HorvatMa/RedPitaya_scan/documentation/RedPitaya_dokumentacija.pdf

# Dokumentacija za sistem zajemanja slik z RedPitayo

## Martin Horvat

## 17. september 2025

## 1 FPGA

Program na FPGA je napisan v jeziku Verilog/SystemVerilog z Vivado 2020.2. Sistem je sestavljen iz sledečih blokov za:

- kontrolo parametrov reg ctrl top,
- zajem signala acquire top in integrator top,
- generiranje signala generate top in waveform top in
- prenos zajetega signala v RAM AXI HP top

Celotna blokovna shema je shranjena v datoteki system.pdf.

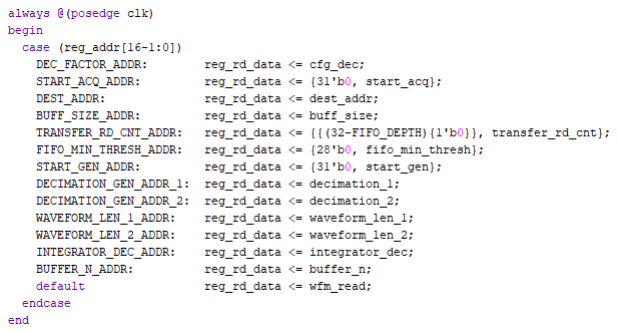
[picture p1: figure]

Slika 1: Koda za branje parametrov

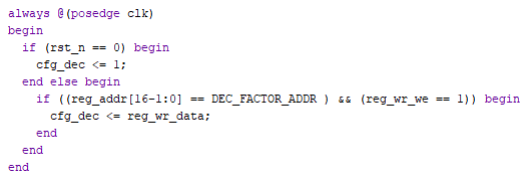
[picture p2: figure]

Slika 2: Koda za zapisovanje parametrov

1

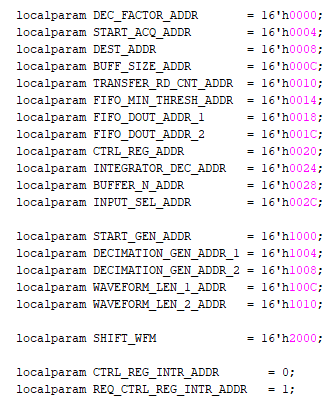
[picture p3: figure]

Slika 3: Definicija lokacij parametrov v delu RAMa

### 1.1 Kontrolni parametri

Blok komunicira s procesnim sistemom preko GP porta AXI protokola, zato ima vhode in izhode kot jih ta zahteva. Komunikacija poteka preko Xilinxovega bloka reg ctrl (Slika 4), kjer lahko nato nastavitve preberemo (Slika 1) oziroma zapišemo (Slika 2). S parametri so definirane lokacije, kjer se v delu RAMa, glede na mapiranje AXI protokola nahajajo spremenljivke (Slika 3). Prebrane vrednosti oziroma registri, ki nosijo vrednost katera se zapiše v RAM, so nato vhodi in izhodi v blok reg ctrl top.

### 1.2 Zajem signala

Signal iz detektorja gre na en ADC vhod, na drugi vhod pa pride signal pozicije hitrega ogledala. Prvi signal gre nato skozi integrator, ki po trapeznem pravilu sešteje prispevke na vhodu v vsakem ciklu ure. Dobljena dva signala skupaj z vrednostjo počasnega signala prideta na vhod bloka acquire top. Ta poskrbi, da se zgodi zapis vrednosti pozicij in integriranega signala na vsakih dec cnt ciklov ure (Slika 5). Hkrati tudi ponastavi integrator.

### 1.3 Generiranje signala

Isti del spomina, ki služi nastavljanju nastavitvenih registrov v bloku ctrl reg, je po nekem mejnem naslovu, definiranem z WFM SHIFT v istem bloku, namenjen vzorcem arbitrarne funkcije, ki jo želimo generirati. In sicer je prvih 16384 vzorcev namenjenih prvi funkciji in preostalih 16384 drugi. Za zapisovanje iz RAMa v pomnilnik na FGPA poskrbi blok waveform top. Vsebuje dva Xilinxova generatorja spomina - vsakega za en izhod (Slika 6). Vrednost, ki jo dobi preko bloka reg Ctrl z informacijo o naslovu, s kjer prihaja vrednost, ki jo prav tako dobi od istega bloka, zapiše na ustrezno pozicijo ustreznega generatorja spomina (Slika 7).

Blok generator top nato poskrbi za branje prave vrednosti iz spomina preko decimacije generatorja,

2

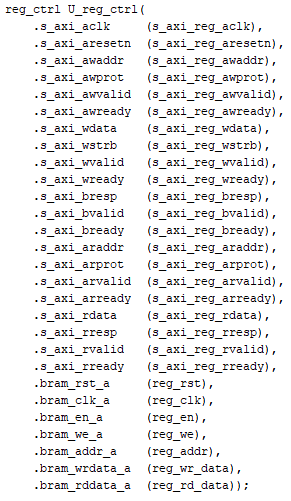
[picture p4: figure]

Slika 4: Xilinxov blok reg ctrl

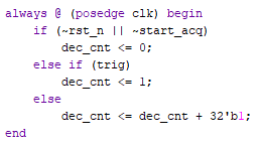
[picture p5: figure]

Slika 5: Koda za proženje zapisa in ponastavitve integratorja

ki jo nato pelje na DAC izhod.

### 1.4 Komunikacija zajetega signala

Najzapletenejši del logike se nahaja v delu, ki skrbi za efektiven prenos zajetega signala iz FIFO v RAM. Za to se namesto GP porta (General Purpose) uporabi port HP (High Performance). Blok

3

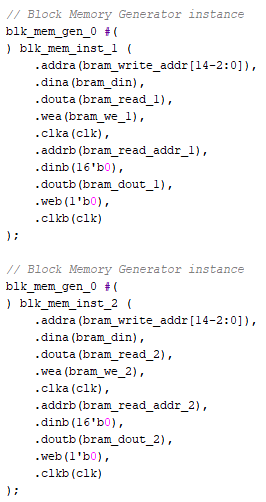
[picture p6: figure]

Slika 6: Dva blokovna spomina za vsakega od izhodov

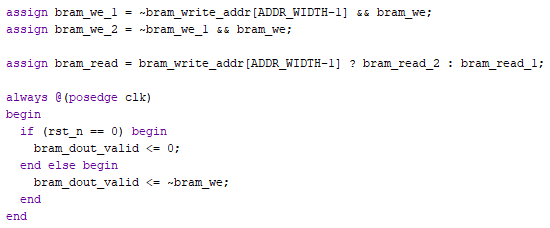
[picture p7: figure]

Slika 7: Izbira pravega spomina za zapis vrednosti

Acquire HP top je sestavljen iz dveh podblokov axi s2mm, ki poskrbi, da logika sledi protokolu AXI in axi control, ki poskrbi za shranjevanje vzorcev v FIFO spomin in iniciacijo prenosa. Ko da blok acquire top signal proženja, se vzorci iz integratorja in dveh pozicijskih signalov (Slika 8) shranijo v FIFO spomin (Slika 9). Ko število shranjenih vzorcev v FIFO spominu preseže mejno vrednost, se inicira prenos v RAM, v kolikor je zastavica request interrupt nastavljena na 1 (Slika 10. Ko je prenos zaključen se postavi zastavica intr na 1, kar sproži interrupt in program na strani OS

4

prebere vzorce iz RAMa. Ko zaključi ponovno postavi zastavico request interrupt na 1 in cikel se ponovi. Skoraj vsa ostala logika poskrbi, da prenos sledi protokolu.

Slika 8: Sestavljanje FIFO zapisa

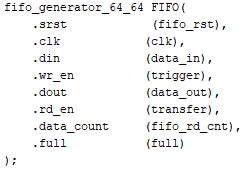
[picture p8: figure]

Slika 9: Zapis v fifo

Slika 10: Zastavice za iniciacio prenosa

5

## 2 DeviceTree

Da lahko na strani OS komuniciramo z napravo, moramo definira, kjeje v RAMu se nahaja. V Vivadu sta v zavihku Address manager definirani poziciji kamor komunicirata GP in HP protokola (Slika 11). V OS dodamo definicijo naprave z devicetree overlayom, ki je prikazan na sliki 12. Relevantni deli so reg, kjer določimo pozicijo v RAM, ki se ujema s tisto nastavljeno v Vivadu in interrupts, kjer je definiran interrupt. To datoteko nato compilamo in apliciramo z ustreznima skriptama compile dt.sh in apply overlay.sh. To doda napravo preko generičnih UIO gonilnikov. Do naprave se lahko tedaj dostopa znotraj C programa.

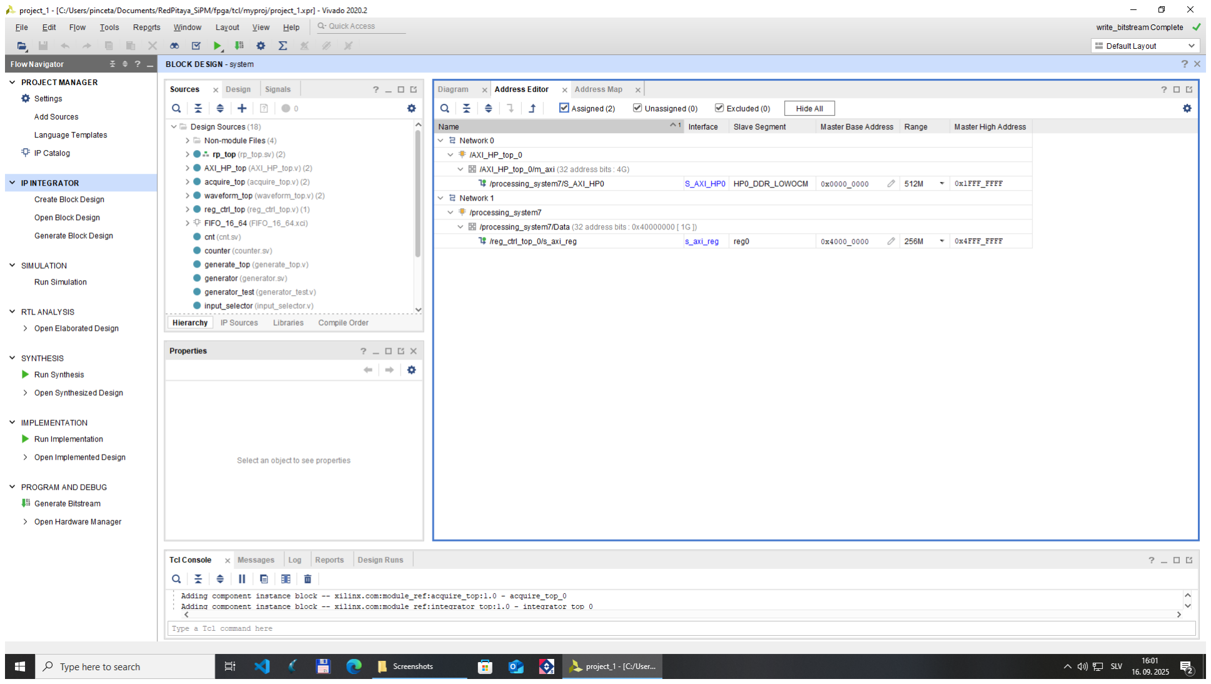
[picture p9: figure]

Slika 11: Definicije pozicij v RAMu, kamor pišeta protokola

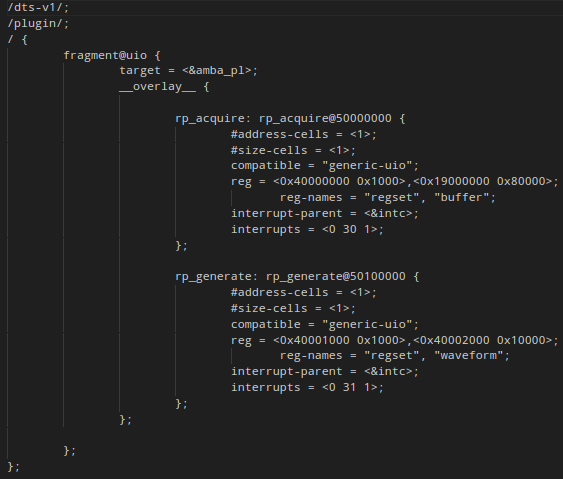
[picture p10: figure]

Slika 12: DeviceTree overlay

6

## 3 C program

### 3.1 Identifikacija UIO naprav

V C kodi lahko najprej poiščemo vse UIO naprave v sistemu in jih shranimo na seznam. Ta seznam lahko nato preiščemo da najdemo pravo naprvao (v našem primeru rp acquire in rp generate). Pomožne funkcije za to so definirane v uio parser.h.

### 3.2 Mapiranje registrov in bufferja

Ko najdemo pravo UIO napravo, lahko pozicije v spominu mapiramo na strukture (Slika 13 in 14). Strukture in funkcije za manipulacijo naprav so definirane v generator.h in oscilloscope.h. Spremenljivke znotraj strukture in njihovi relativni naslovi sovpadajo s tistimi definiranimi na sliki
3. Enako velja za waveform, kjer je spomin razdeljen na dva dela, vsakega za en izhod (Slika 14). Ko torej spremenimo katerokoli od spremenljivk znotraj mapiranih struktur, oz. jo preberemo, bo logika v FPGA poskrbela, da se sprememba zapiše oz. prebere.

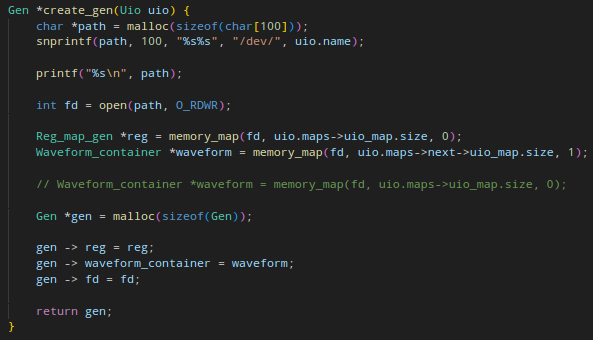
[picture p11: figure]

Slika 13: Funkcija za dodajanje generatorja

### 3.3 Prenos FIFO v RAM

Ko so doseženi pogoji za prenos na FPGA strani, se začne prenos in ko se ta konča, FPGA sproži interrupt. Da ga ujamemo, moramo zanj poslušati (Slika 15). Ko ga program zazna, prenese vse podatke iz deljenega dela RAM na drugo pozicijo in zaprosi za nov interrupt (Slika 16), saj je tedaj del RAMa prost za nove podatke. Cikel se nato ponovi.

### 3.4 TCP komunikacija

Ko program prenese podatke iz deljenega RAM dela, jih takoj zapiše v buffer (Slika 16) in inicira TCP prenos do klienta na osebnem računalniku, kjer se sestavi slika na podlagi zgornje in spodnje meje pozicije in resolucije.

7

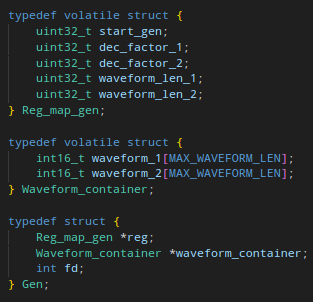
[picture p12: figure]

Slika 14: Definicija struktur za generator

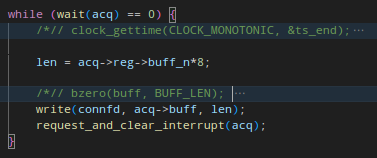
[picture p13: figure]

Slika 15: Poslušanje za interrupt znotraj TCP zanke

Slika 16: Brisanje interrupta in zaprošanje za novega

8
