HorvatMa/RedPitaya_scan/documentation/screenshots/create_acq.png

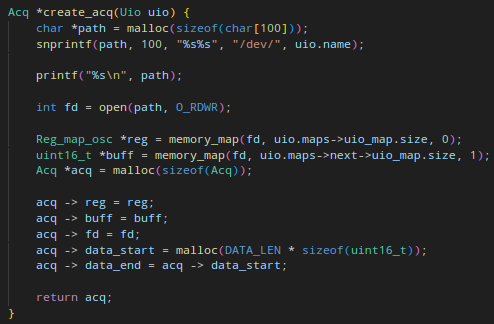
documentation/screenshots/create_acq.png
