HorvatMa/RedPitaya_scan/documentation/screenshots/get_uios.png

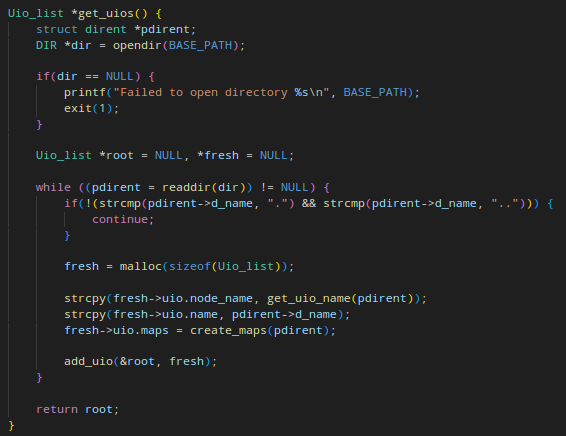
documentation/screenshots/get_uios.png
