HorvatMa/RedPitaya_scan/documentation/screenshots/Screenshot (24).png

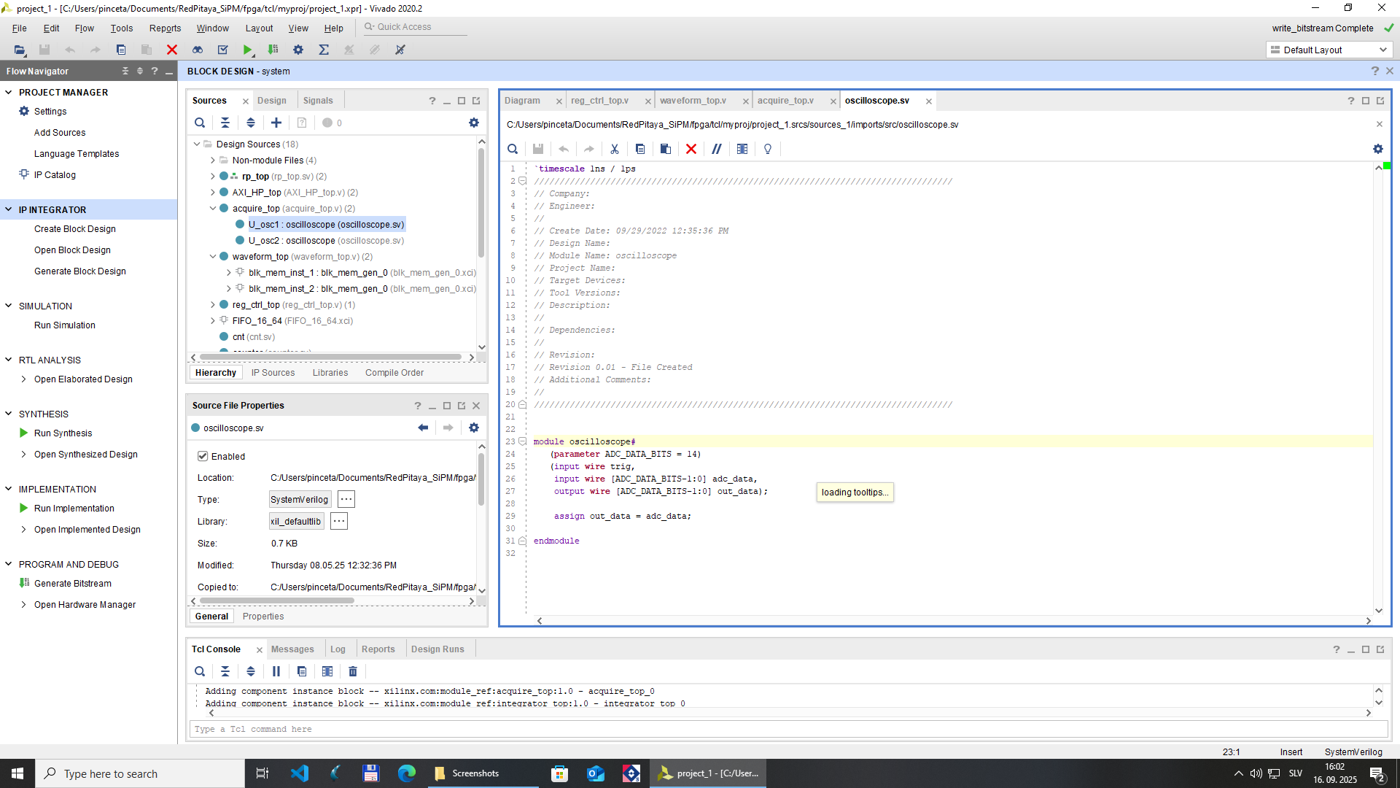
documentation/screenshots/Screenshot (24).png
