HorvatMa/RedPitaya_scan/documentation/screenshots/Screenshot (25).png

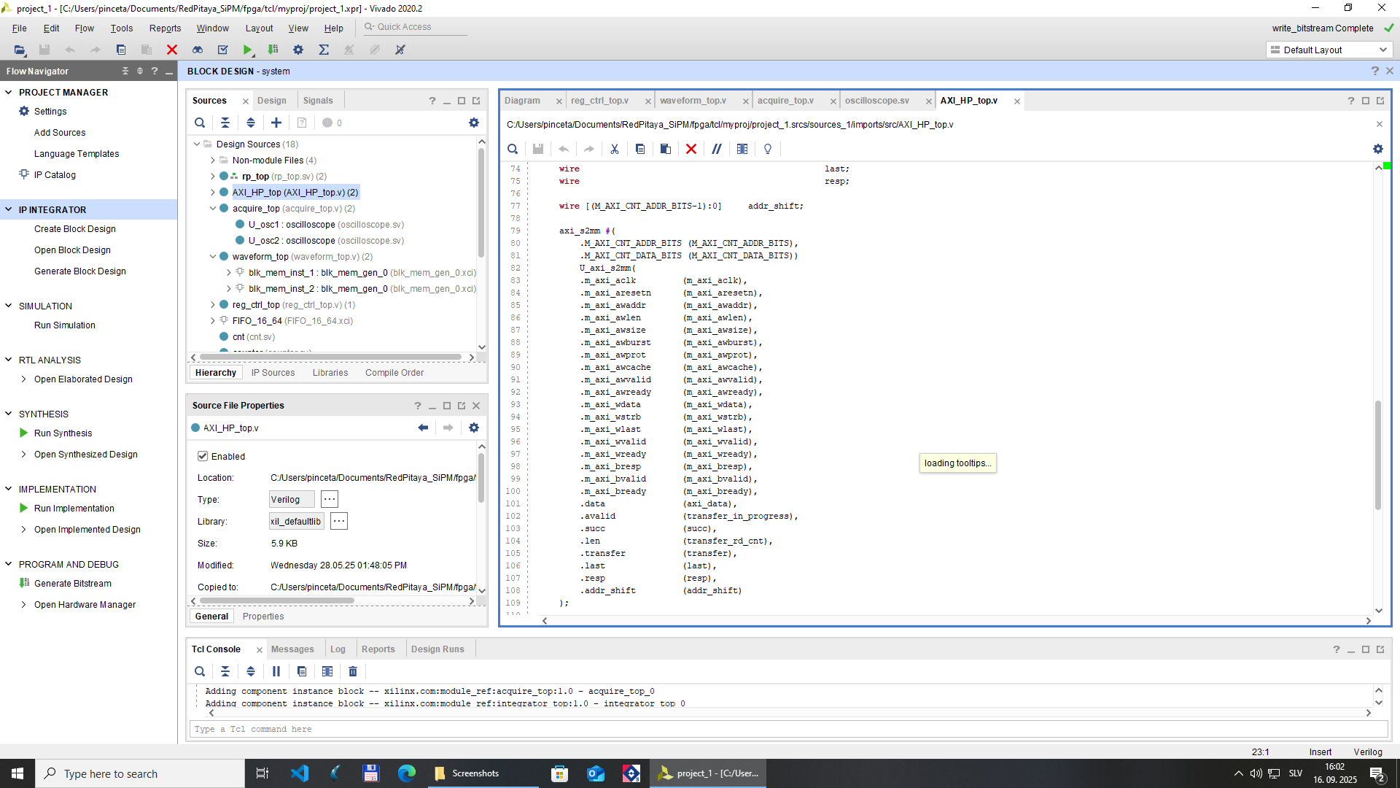
documentation/screenshots/Screenshot (25).png
