HorvatMa/RedPitaya_scan/documentation/screenshots/Screenshot (26).png

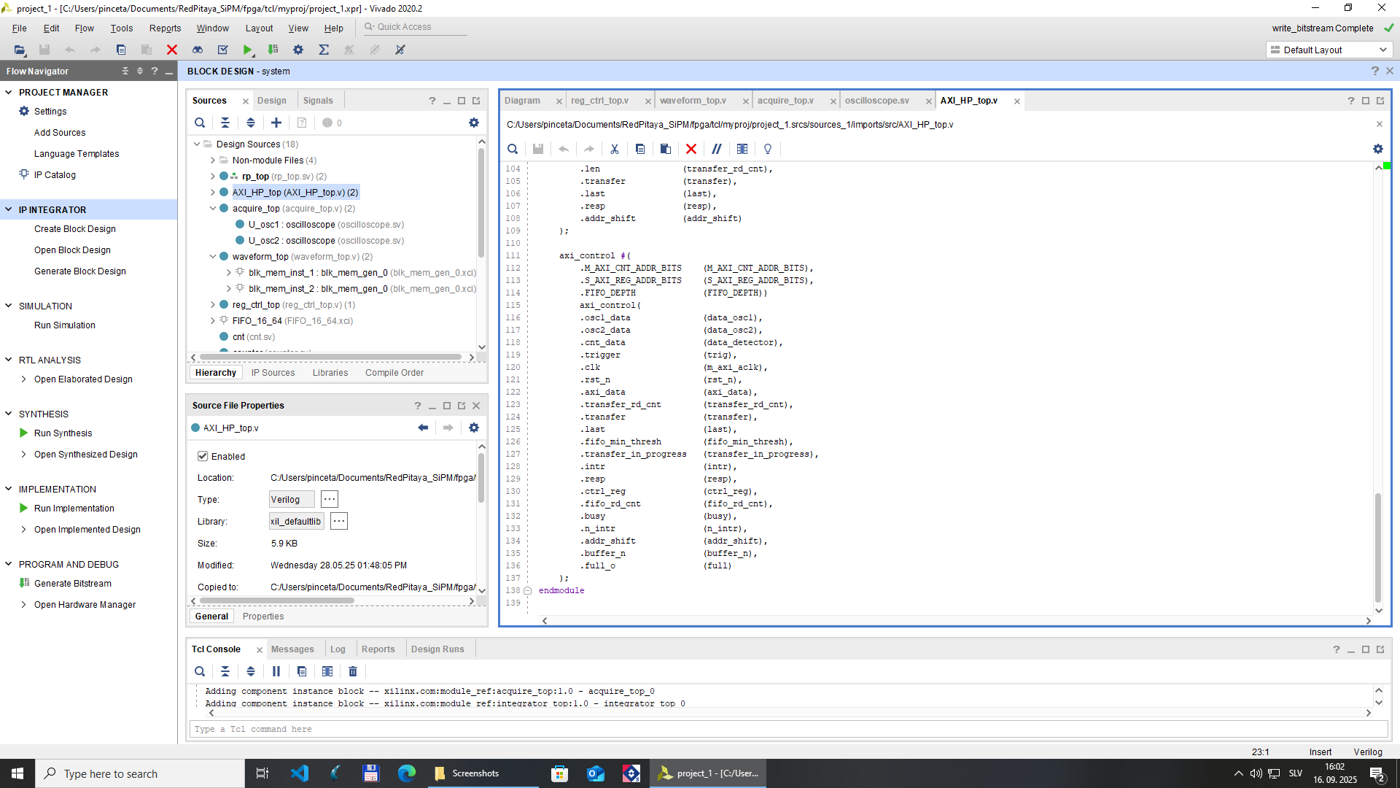
documentation/screenshots/Screenshot (26).png
