HorvatMa/RedPitaya_scan/documentation/screenshots/Screenshot (27).png

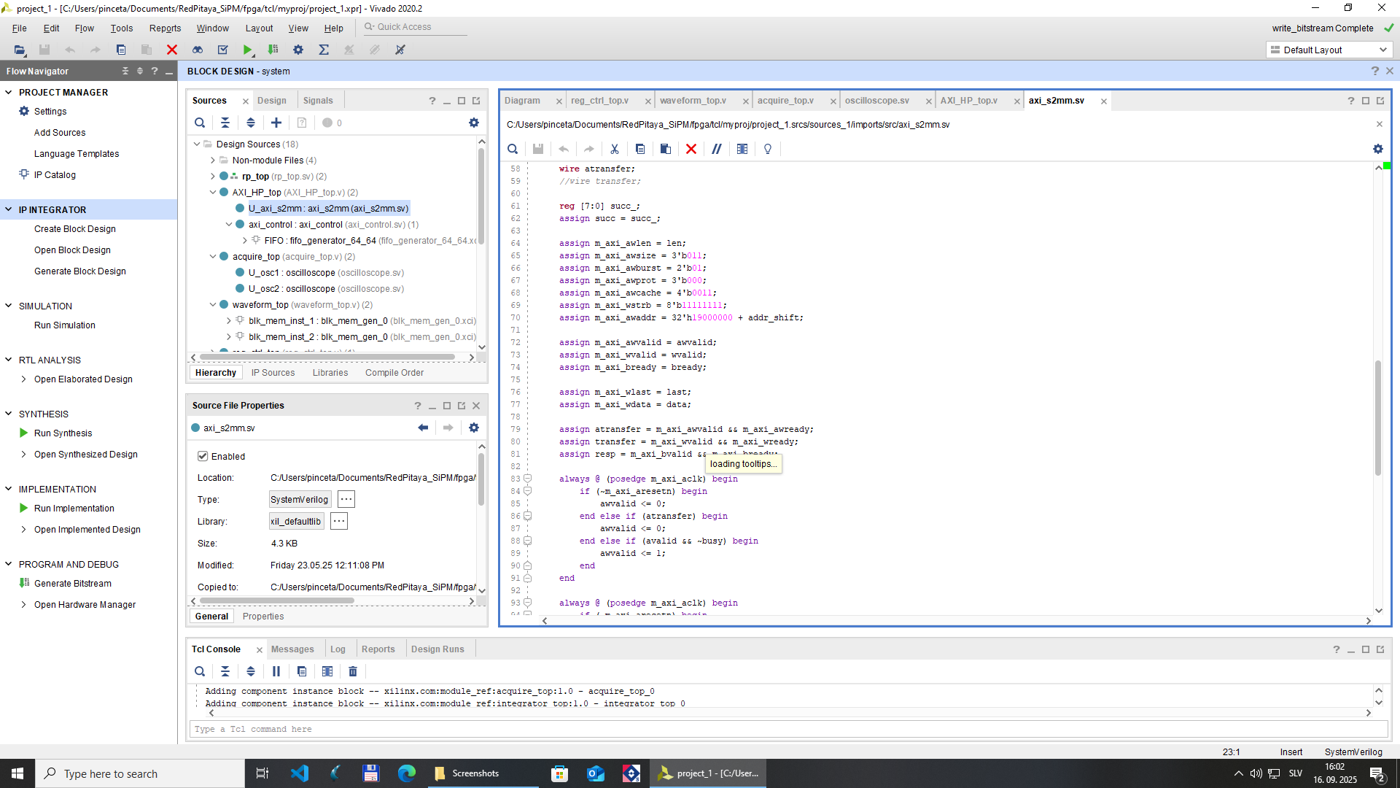
documentation/screenshots/Screenshot (27).png
