HorvatMa/RedPitaya_scan/documentation/screenshots/Screenshot (28).png

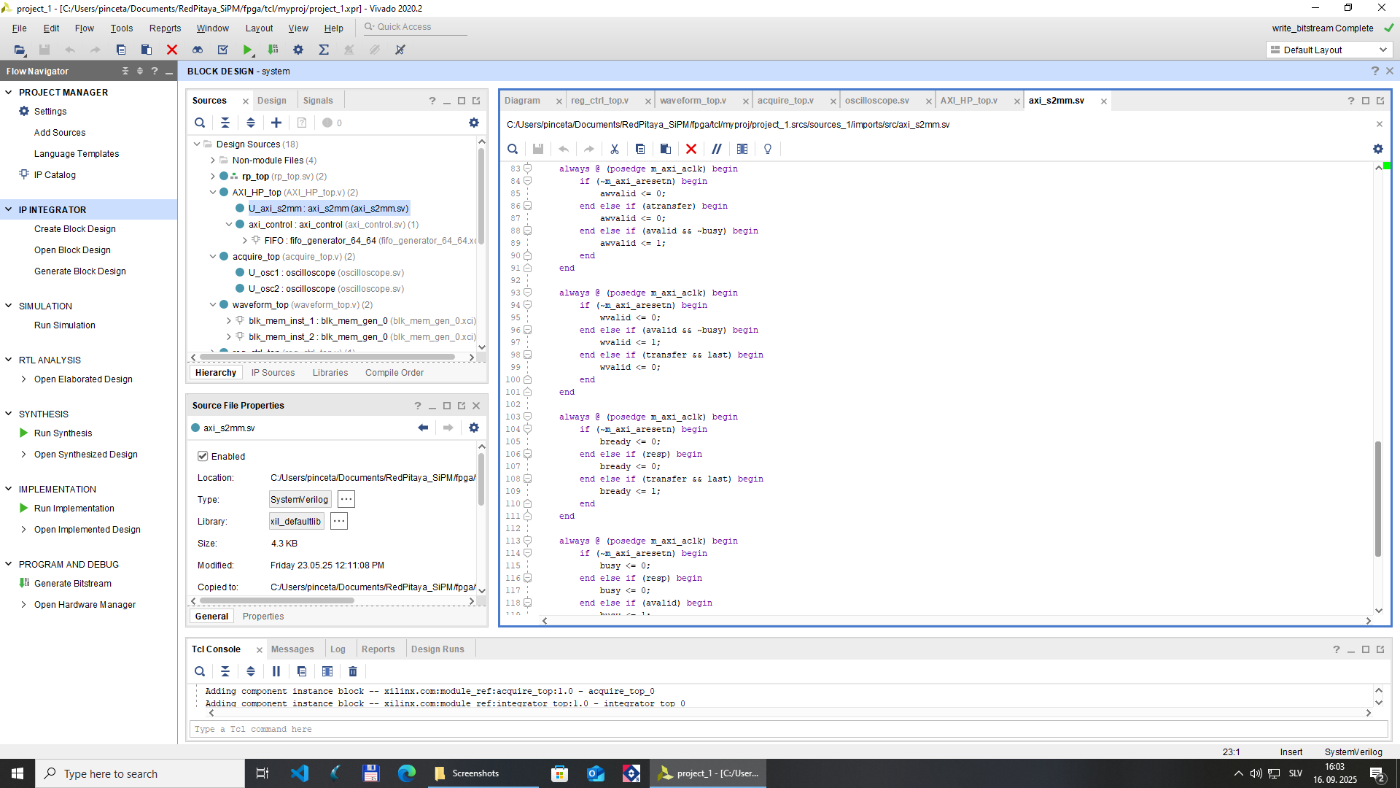
documentation/screenshots/Screenshot (28).png
