HorvatMa/RedPitaya_scan/documentation/screenshots/Screenshot (29).png

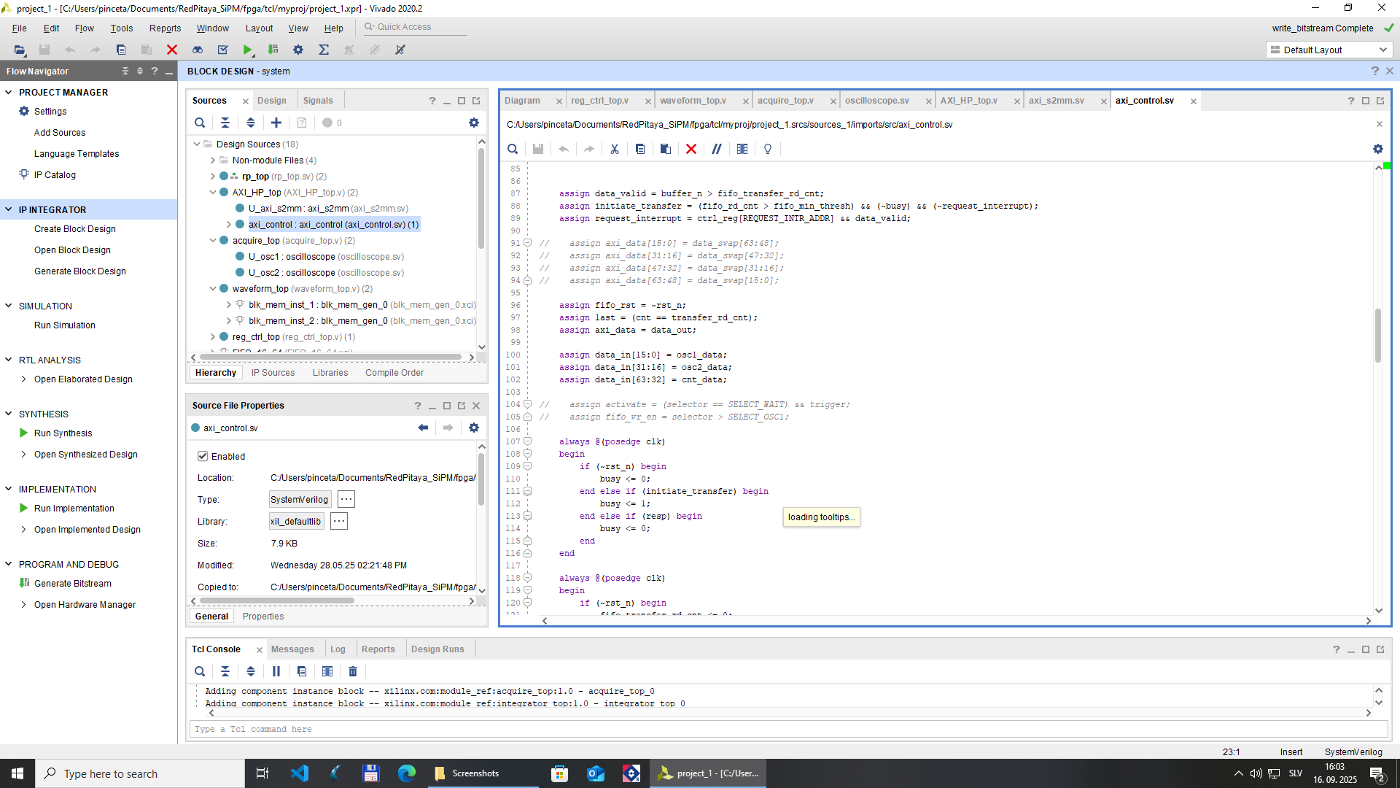
documentation/screenshots/Screenshot (29).png
