HorvatMa/RedPitaya_scan/documentation/screenshots/Screenshot (30).png

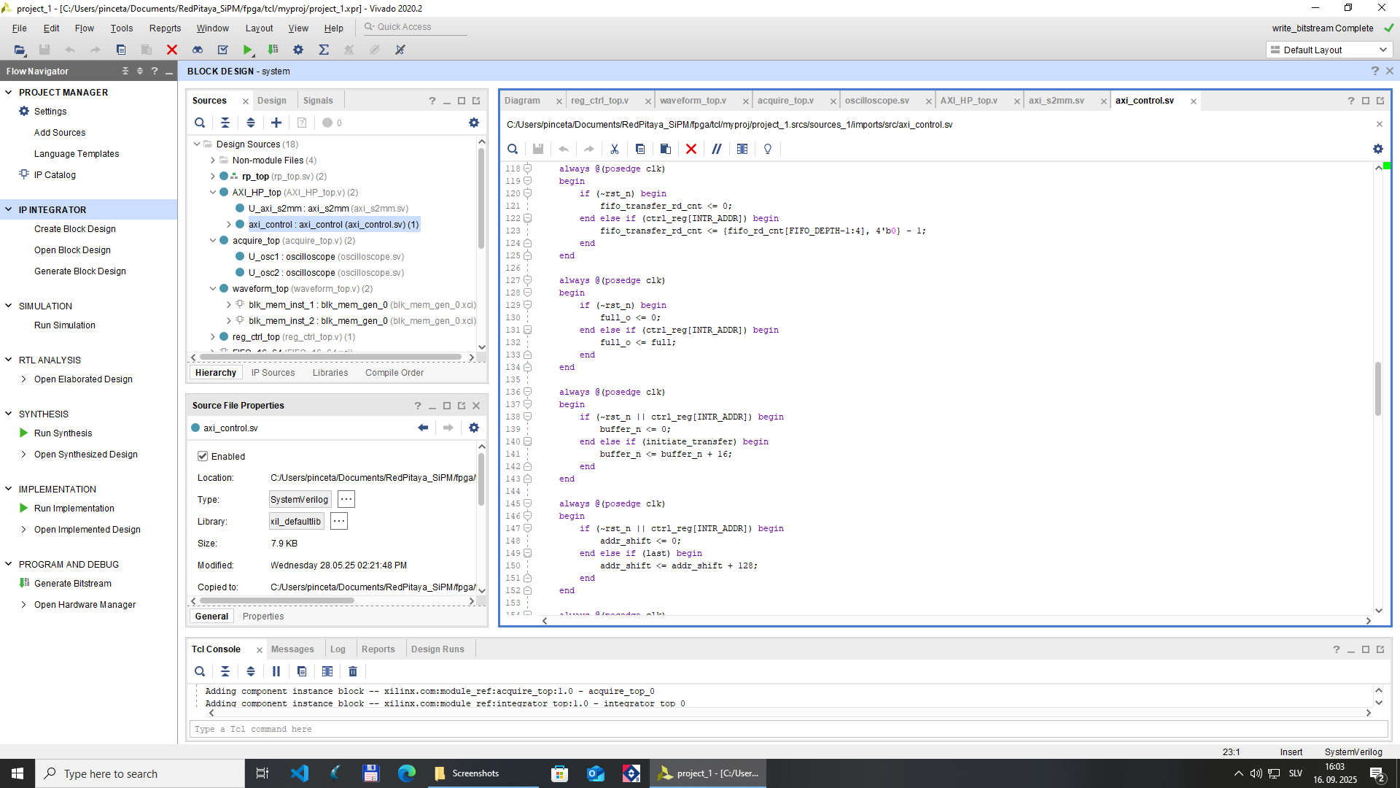
documentation/screenshots/Screenshot (30).png
