HorvatMa/RedPitaya_scan/documentation/screenshots/Screenshot (34).png

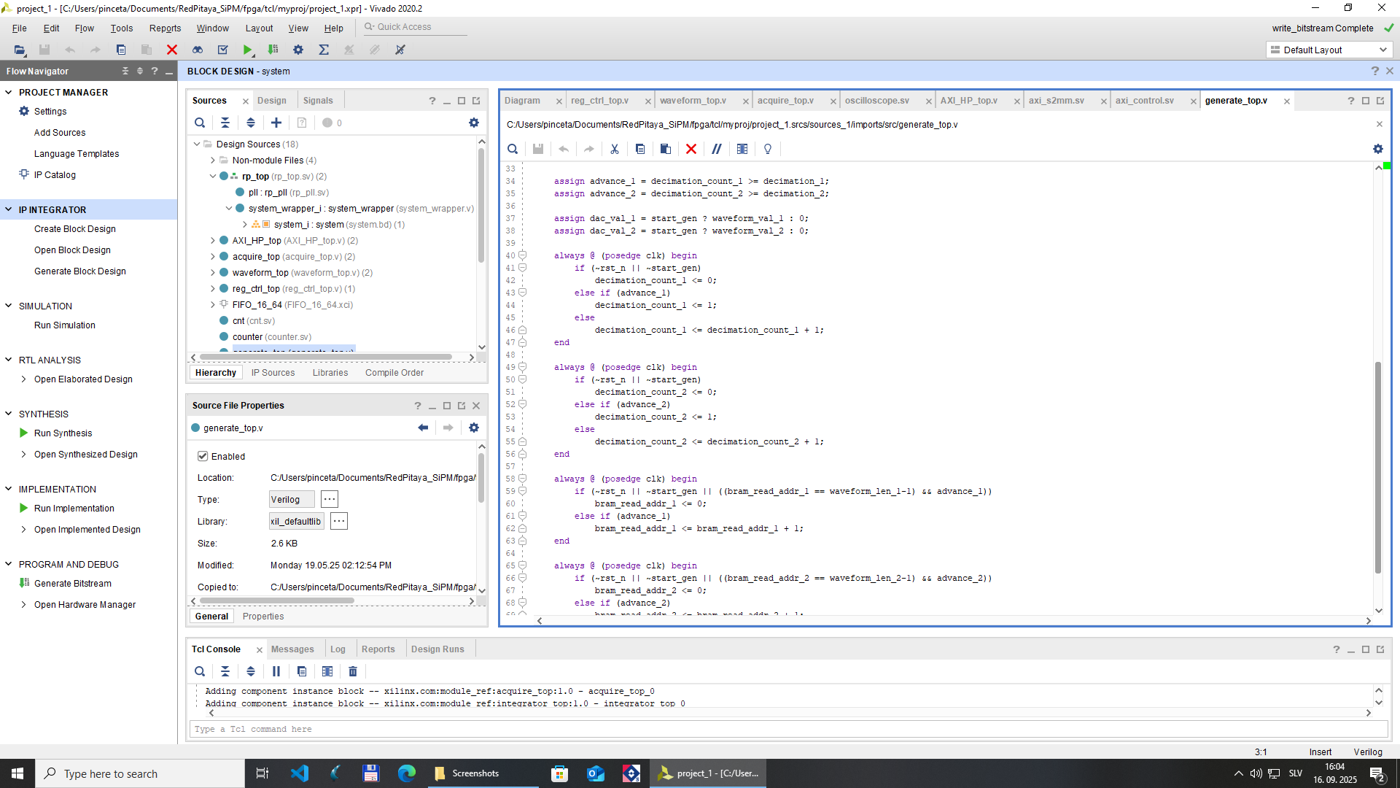
documentation/screenshots/Screenshot (34).png
