HorvatMa/RedPitaya_scan/documentation/screenshots/trig.png

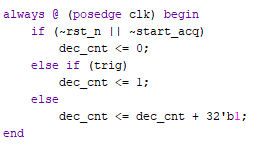
documentation/screenshots/trig.png
