HorvatMa/RedPitaya_scan/documentation/screenshots/uio_by_name.png

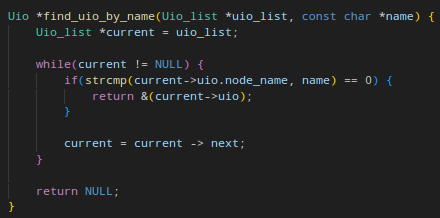
documentation/screenshots/uio_by_name.png
