HorvatMa/RedPitaya_scan/PCB/production/bom.csv

Designator | Footprint | Quantity | Value | LCSC Part #
C1, C11, C13, C14, C17, C19, C20, C22, C3, C4, C5, C6, C9 | 0805 | 13 | 1u
C10, C12, C15, C16, C18, C2, C21, C23, C7, C8 | 0805 | 10 | 100n
C24, C25, C26, C27 | CP_Radial_D10.0mm_P5.00mm | 4 | 47u
D1, D2 | 0805 | 2 | LED | C2297
H1, H2, H3, H4 | MountingHole_3.2mm_M3_DIN965_Pad | 4 | ~
J10, J11, J3, J4, J8 | PinHeader_1x03_P2.54mm_Vertical | 5 | Conn_01x03_Pin
J12 | CONN_24.243_MTC | 1 | +15 V
J13 | CONN_24.243_MTC | 1 | GND
J14 | CONN_24.243_MTC | 1 | -15 V
R1, R15, R16, R2, R3, R5 | 0805 | 6 | 50
R10, R11, R13, R14, R18, R19, R20, R6, R8, R9 | 0805 | 10 | 10k
R12, R17, R4, R7 | 0805 | 4 | 1k
R21, R22 | 0805 | 2 | 4k7
RF1, RF2, RF3, RF4, RF5, RF6 | SMA-TH_BWSMA-KWE-Z001 | 6 | BWSMA-KWE-Z001 | C496551
RV1, RV2, RV3, RV4, RV5, RV6 | Potentiometer_Bourns_PTV09A-1_Single_Vertical | 6 | 10k
U1, U3, U5 | SOIC-8_3.9x4.9mm_P1.27mm | 3 | NE5532
U2, U4 | SOIC8_D_TEX | 2 | Opamp_Dual
