HorvatMa/RedPitaya_scan/documentation/system.pdf

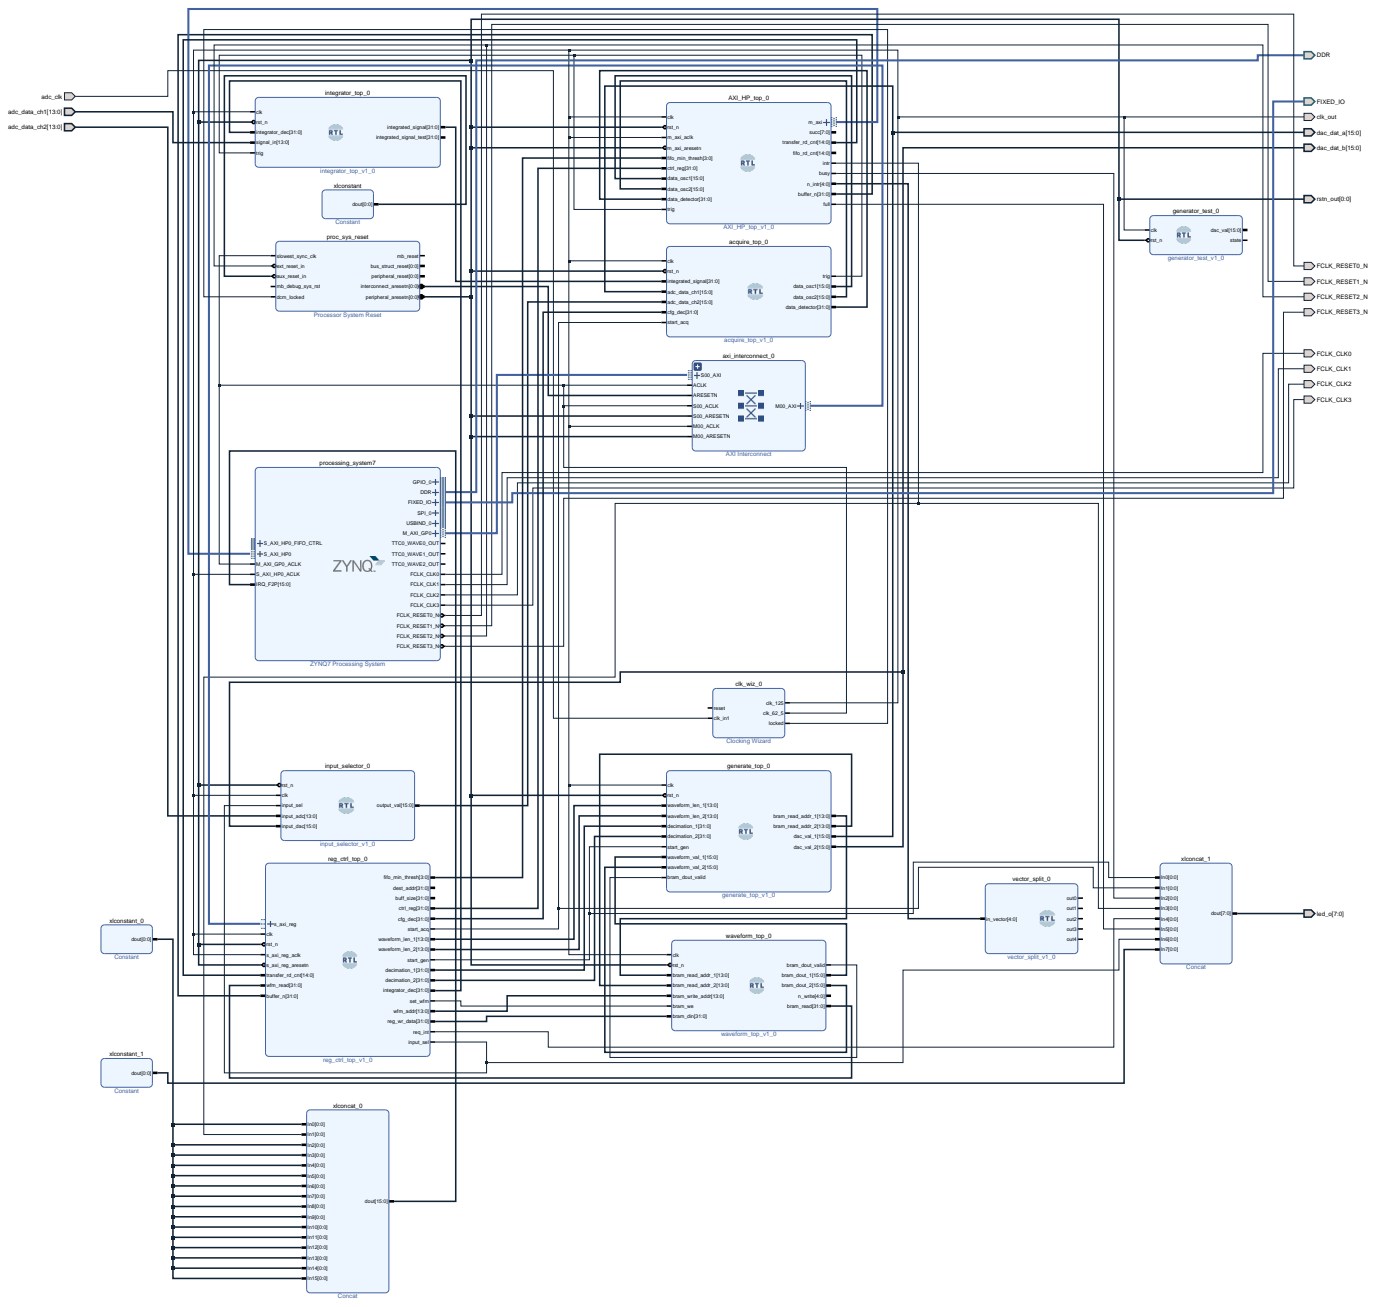
[picture p26: page 1]
AXI_HP_top_0; AXI_HP_top_v1_0; m_axi clk; rst_n m_axi_aclk m_axi_aresetn; succ[7:0]; fifo_min_thresh[3:0]; transfer_rd_cnt[14:0]; fifo_rd_cnt[14:0]; ctrl_reg[31:0] data_osc1[15:0] data_osc2[15:0] data_detector[31:0]; intr; trig; busy n_intr[4:0] buffer_n[31:0]; full; DDR; FCLK_CLK0; FCLK_CLK1; FCLK_CLK2; FCLK_CLK3; FCLK_RESET0_N; FCLK_RESET1_N; FCLK_RESET2_N; FCLK_RESET3_N; FIXED_IO; acquire_top_0; acquire_top_v1_0; clk; rst_n; integrated_signal[31:0] adc_data_ch1[15:0] adc_data_ch2[15:0]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

Processor System Reset

clk_wiz_0

input_selector_0
