HorvatMa/RedPitaya_scan/PCB/SHG_amp.kicad_pcb

## KiCad design PCB/SHG_amp.kicad_pcb (2026-10-27)

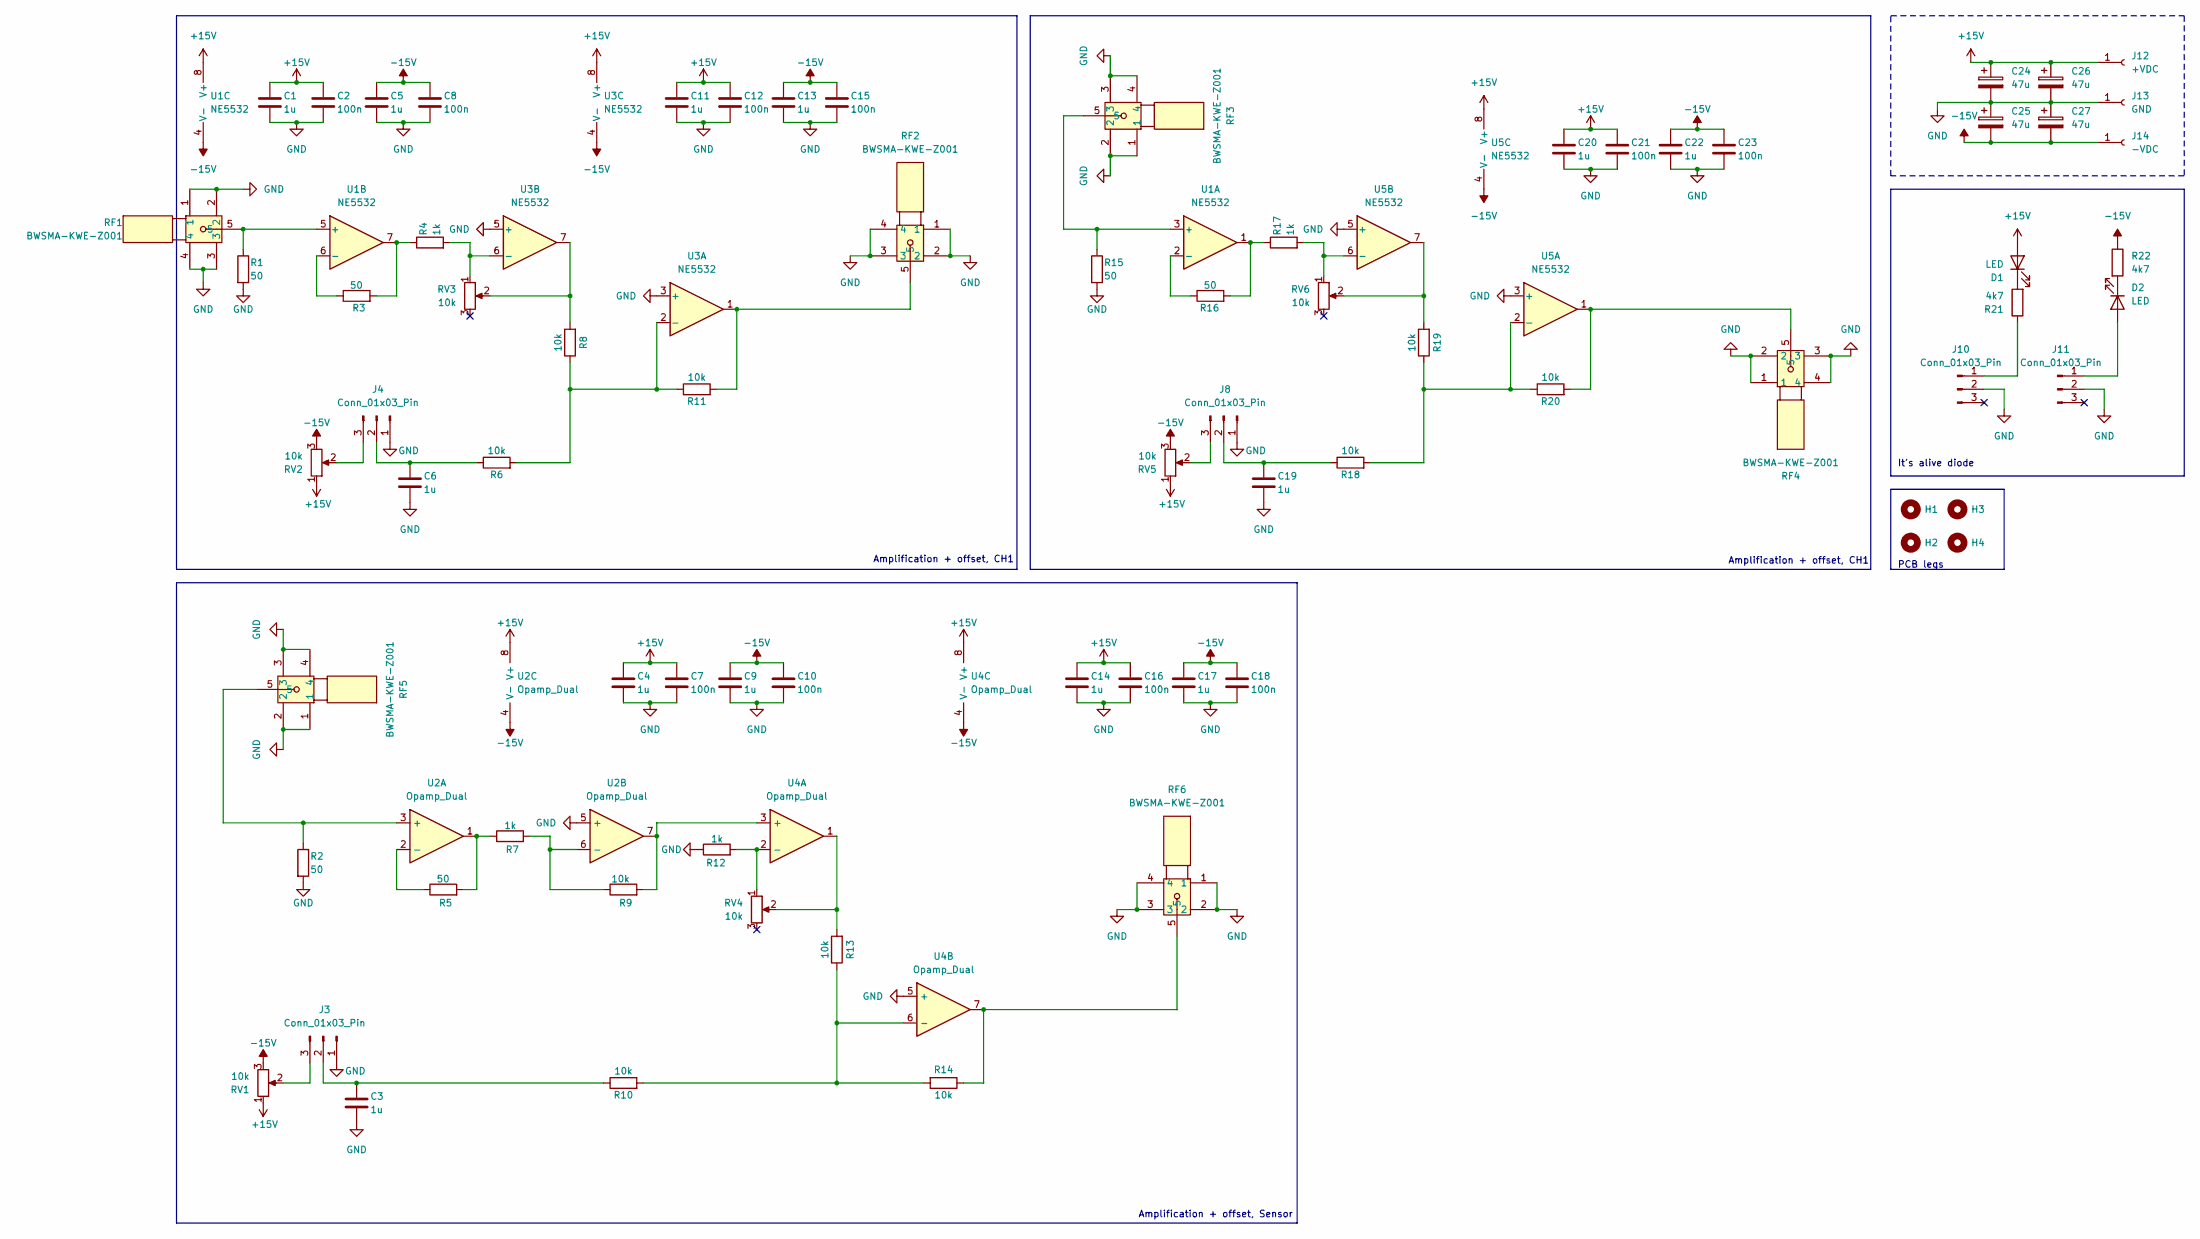
[picture p27: schematic SHG_amp.kicad_sch]

Parts:
C1, C3, C4, C5, C6, C9, C11, C13, C14, C17, C19, C20, C22: 1u; C_0805_2012Metric_Pad1.18x1.45mm_HandSolder
C2, C7, C8, C10, C12, C15, C16, C18, C21, C23: 100n; C_0805_2012Metric_Pad1.18x1.45mm_HandSolder
C24, C25, C26, C27: 47u; CP_Radial_D10.0mm_P5.00mm
D1, D2: LED; LED_0805_2012Metric_Pad1.15x1.40mm_HandSolder; LCSC C2297
H1, H2, H3, H4: MountingHole_3.2mm_M3_DIN965_Pad
J3, J4, J8, J10, J11: Conn_01x03_Pin; PinHeader_1x03_P2.54mm_Vertical
J12: +VDC; CONN_24.243_MTC
J13: GND; CONN_24.243_MTC
J14: -VDC; CONN_24.243_MTC
R1, R2, R3, R5, R15, R16: 50; R_0805_2012Metric_Pad1.20x1.40mm_HandSolder
R4, R7, R12, R17: 1k; R_0805_2012Metric_Pad1.20x1.40mm_HandSolder
R6, R8, R9, R10, R11, R13, R14, R18, R19, R20: 10k; R_0805_2012Metric_Pad1.20x1.40mm_HandSolder
R21, R22: 4k7; R_0805_2012Metric_Pad1.20x1.40mm_HandSolder
RF1, RF2, RF3, RF4, RF5, RF6: BWSMA-KWE-Z001; SMA-TH_BWSMA-KWE-Z001; LCSC Part C496551
RV1, RV2, RV3, RV4, RV5, RV6: 10k; Potentiometer_Bourns_PTV09A-1_Single_Vertical
U1, U3, U5: NE5532; SOIC-8_3.9x4.9mm_P1.27mm
U2, U4: Opamp_Dual; SOIC8_D_TEX

Connections:
+15V: C1.1, C2.1, C4.1, C7.1, C11.1, C12.1, C14.1, C16.1, C20.1, C21.1, C24.1, C26.1, D1.2 (A), J12.1, RV1.1, RV2.1, RV5.1, U1.8 (V+), U2.8 (V+), U3.8 (V+), U4.8 (V+), U5.8 (V+)
-15V: C5.1, C8.1, C9.1, C10.1, C13.1, C15.1, C17.1, C18.1, C22.1, C23.1, C25.2, C27.2, J14.1, R22.1, RV1.3, RV2.3, RV5.3, U1.4 (V-), U2.4 (V-), U3.4 (V-), U4.4 (V-), U5.4 (V-)
GND: C1.2, C2.2, C3.2, C4.2, C5.2, C6.2, C7.2, C8.2, C9.2, C10.2, C11.2, C12.2, C13.2, C14.2, C15.2, C16.2, C17.2, C18.2, C19.2, C20.2, C21.2, C22.2, C23.2, C24.2, C25.1, C26.2, C27.1, J3.1, J4.1, J8.1, J10.2, J11.2, J13.1, R1.2, R2.2, R12.1, R15.2, RF1.1, RF1.2, RF1.3, RF1.4, RF2.1, RF2.2, RF2.3, RF2.4, RF3.1, RF3.2, RF3.3, RF3.4, RF4.1, RF4.2, RF4.3, RF4.4, RF5.1, RF5.2, RF5.3, RF5.4, RF6.1, RF6.2, RF6.3, RF6.4, U2.5 (+), U3.3 (+), U3.5 (+), U4.5 (+), U5.3 (+), U5.5 (+)
unnamed: D1.1 (K), R21.2
unnamed: D2.2 (A), J11.1
unnamed: D2.1 (K), R22.2
unnamed: C3.1, J3.2, R10.1
unnamed: J3.3, RV1.2
unnamed: C6.1, J4.2, R6.1
unnamed: J4.3, RV2.2
unnamed: C19.1, J8.2, R18.1
unnamed: J8.3, RV5.2
unnamed: J10.1, R21.1
unnamed: R3.2, R4.1, U1.7
unnamed: R5.2, R7.1, U2.1
unnamed: R8.2, RV3.2, U3.7
unnamed: R11.2, RF2.5, U3.1
unnamed: R13.2, RV4.2, U4.1
unnamed: R14.1, RF6.5, U4.7
unnamed: R16.2, R17.1, U1.1
unnamed: R19.2, RV6.2, U5.7
unnamed: R20.2, RF4.5, U5.1
unnamed: R15.1, RF3.5, U1.3 (+)
unnamed: R16.1, U1.2 (-)
unnamed: R1.1, RF1.5, U1.5 (+)
unnamed: R3.1, U1.6 (-)
unnamed: R2.1, RF5.5, U2.3 (+)
unnamed: R5.1, U2.2 (-)
unnamed: R7.2, R9.1, U2.6 (-)
unnamed: R6.2, R8.1, R11.1, U3.2 (-)
unnamed: R4.2, RV3.1, U3.6 (-)
unnamed: R9.2, U2.7, U4.3 (+)
unnamed: R12.2, RV4.1, U4.2 (-)
unnamed: R10.2, R13.1, R14.2, U4.6 (-)
unnamed: R18.2, R19.1, R20.1, U5.2 (-)
unnamed: R17.2, RV6.1, U5.6 (-)

Notes on the sheet:
Amplification + offset, Sensor
PCB legs
Amplification + offset, CH1
It's alive diode

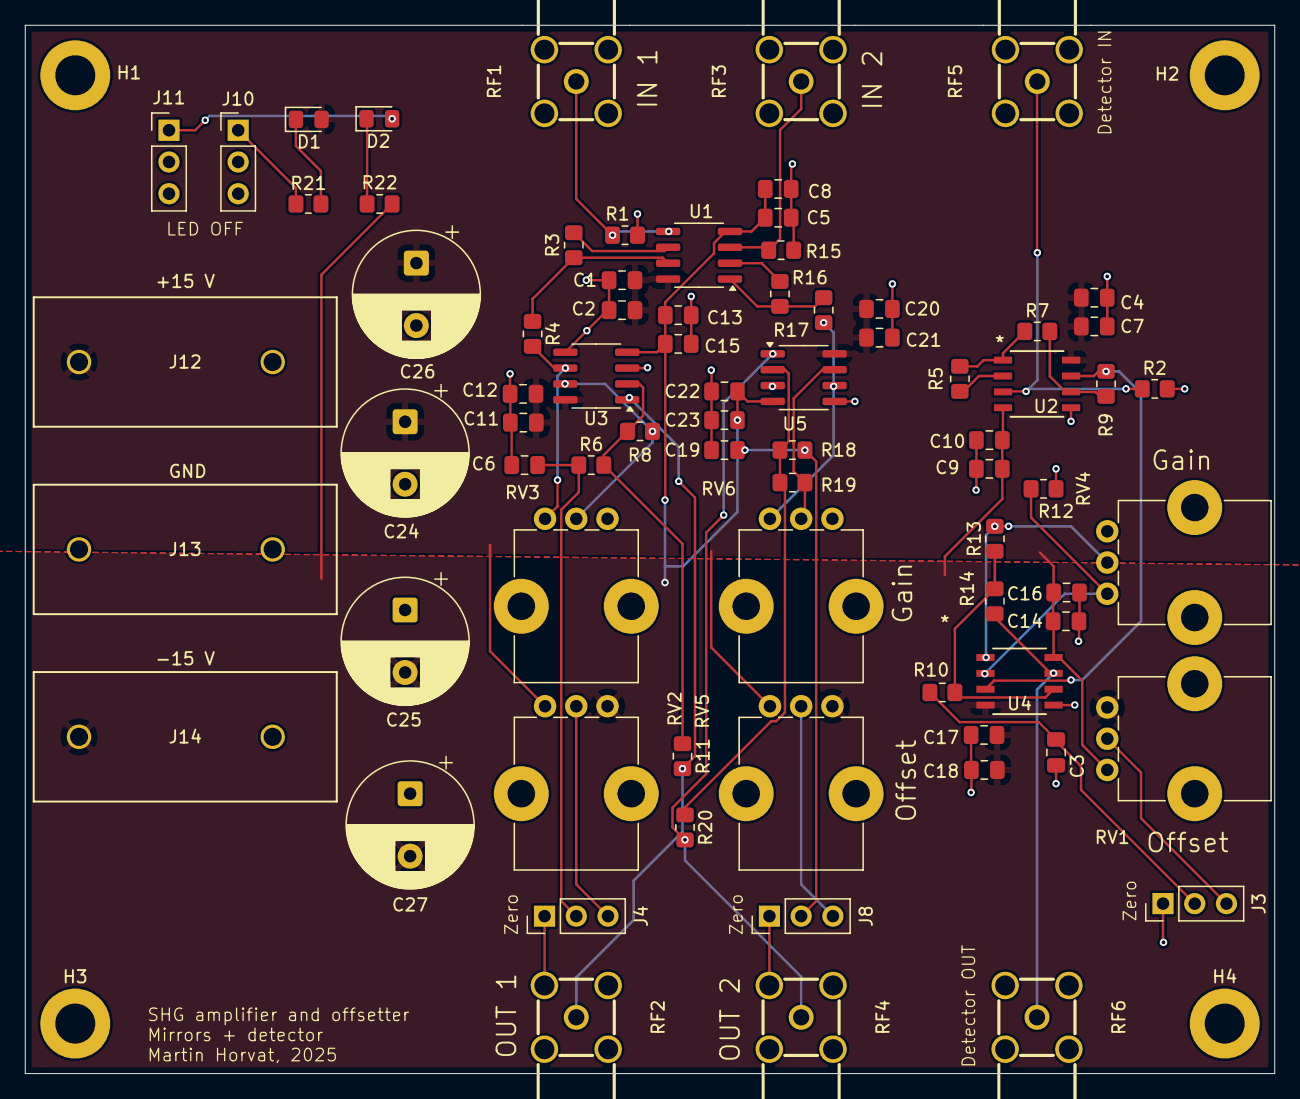
[picture p28: board SHG_amp.kicad_pcb from above]

Board: 2 copper layers, 100.0 x 83.9 mm, 80 parts (0 on the bottom side), 36 nets.
