HorvatMa/RedPitaya_scan/vivado/sources_1/imports/classic/rtl/classic/red_pitaya_scope.v

/**
 * $Id: red_pitaya_scope.v 965 2014-01-24 13:39:56Z matej.oblak $
 *
 * @brief Red Pitaya oscilloscope application, used for capturing ADC data
 *        into BRAMs, which can be later read by SW.
 *
 * @Author Matej Oblak
 *
 * (c) Red Pitaya  http://www.redpitaya.com
 *
 * This part of code is written in Verilog hardware description language (HDL).
 * Please visit http://en.wikipedia.org/wiki/Verilog
 * for more details on the language used herein.
 */

/**
 * GENERAL DESCRIPTION:
 *
 * This is simple data aquisition module, primerly used for scilloscope 
 * application. It consists from three main parts.
 *
 *
 *                /--------\      /-----------\            /-----\
 *   ADC CHA ---> | DFILT1 | ---> | AVG & DEC | ---------> | BUF | --->  SW
 *                \--------/      \-----------/     |      \-----/
 *                                                  ˇ         ^
 *                                              /------\      |
 *   ext trigger -----------------------------> | TRIG | -----+
 *                                              \------/      |
 *                                                  ^         ˇ
 *                /--------\      /-----------\     |      /-----\
 *   ADC CHB ---> | DFILT1 | ---> | AVG & DEC | ---------> | BUF | --->  SW
 *                \--------/      \-----------/            \-----/ 
 *
 *
 * Input data is optionaly averaged and decimated via average filter.
 *
 * Trigger section makes triggers from input ADC data or external digital 
 * signal. To make trigger from analog signal schmitt trigger is used, external
 * trigger goes first over debouncer, which is separate for pos. and neg. edge.
 *
 * Data capture buffer is realized with BRAM. Writing into ram is done with 
 * arm/trig logic. With adc_arm_do signal (SW) writing is enabled, this is active
 * until trigger arrives and adc_dly_cnt counts to zero. Value adc_wp_trig
 * serves as pointer which shows when trigger arrived. This is used to show
 * pre-trigger data.
 * 
 */

module red_pitaya_scope #(
  parameter CHN = 0 ,
  parameter RSZ = 14  // RAM size 2^RSZ
)(
   // ADC
   input                 adc_clk_i       ,  // ADC clock
   input                 adc_rstn_i      ,  // ADC reset - active low
   input      [ 14-1: 0] adc_a_i         ,  // ADC data CHA
   input      [ 14-1: 0] adc_b_i         ,  // ADC data CHB
   // trigger sources
   input                 trig_ext_i      ,  // external trigger
   input                 trig_asg_i      ,  // ASG trigger
   output     [  4-1: 0] trig_ch_o       ,  // output trigger to ADC for other 2 channels
   input      [  4-1: 0] trig_ch_i       ,  // input ADC trigger from other 2 channels

   // AXI0 master
   output                axi0_clk_o      ,  // global clock
   output                axi0_rstn_o     ,  // global reset
   output     [ 32-1: 0] axi0_waddr_o    ,  // system write address
   output     [ 64-1: 0] axi0_wdata_o    ,  // system write data
   output     [  8-1: 0] axi0_wsel_o     ,  // system write byte select
   output                axi0_wvalid_o   ,  // system write data valid
   output     [  4-1: 0] axi0_wlen_o     ,  // system write burst length
   output                axi0_wfixed_o   ,  // system write burst type (fixed / incremental)
   input                 axi0_werr_i     ,  // system write error
   input                 axi0_wrdy_i     ,  // system write ready

   // AXI1 master
   output                axi1_clk_o      ,  // global clock
   output                axi1_rstn_o     ,  // global reset
   output     [ 32-1: 0] axi1_waddr_o    ,  // system write address
   output     [ 64-1: 0] axi1_wdata_o    ,  // system write data
   output     [  8-1: 0] axi1_wsel_o     ,  // system write byte select
   output                axi1_wvalid_o   ,  // system write data valid
   output     [  4-1: 0] axi1_wlen_o     ,  // system write burst length
   output                axi1_wfixed_o   ,  // system write burst type (fixed / incremental)
   input                 axi1_werr_i     ,  // system write error
   input                 axi1_wrdy_i     ,  // system write ready
  
   // System bus
   input      [ 32-1: 0] sys_addr      ,  // bus saddress
   input      [ 32-1: 0] sys_wdata     ,  // bus write data
   input                 sys_wen       ,  // bus write enable
   input                 sys_ren       ,  // bus read enable
   output reg [ 32-1: 0] sys_rdata     ,  // bus read data
   output reg            sys_err       ,  // bus error indicator
   output reg            sys_ack          // bus acknowledge signal
);

reg             adc_arm_do   ;
reg             adc_rst_do   ;

//---------------------------------------------------------------------------------
//  Input filtering
wire [ 14-1: 0] adc_a_filt_in  ;
wire [ 14-1: 0] adc_a_filt_out ;
wire [ 14-1: 0] adc_b_filt_in  ;
wire [ 14-1: 0] adc_b_filt_out ;
reg  [ 18-1: 0] set_a_filt_aa  ;
reg  [ 25-1: 0] set_a_filt_bb  ;
reg  [ 25-1: 0] set_a_filt_kk  ;
reg  [ 25-1: 0] set_a_filt_pp  ;
reg  [ 18-1: 0] set_b_filt_aa  ;
reg  [ 25-1: 0] set_b_filt_bb  ;
reg  [ 25-1: 0] set_b_filt_kk  ;
reg  [ 25-1: 0] set_b_filt_pp  ;

assign adc_a_filt_in = adc_a_i ;
assign adc_b_filt_in = adc_b_i ;

red_pitaya_dfilt1 i_dfilt1_cha (
   // ADC
  .adc_clk_i   ( adc_clk_i       ),  // ADC clock
  .adc_rstn_i  ( adc_rstn_i      ),  // ADC reset - active low
  .adc_dat_i   ( adc_a_filt_in   ),  // ADC data
  .adc_dat_o   ( adc_a_filt_out  ),  // ADC data
   // configuration
  .cfg_aa_i    ( set_a_filt_aa   ),  // config AA coefficient
  .cfg_bb_i    ( set_a_filt_bb   ),  // config BB coefficient
  .cfg_kk_i    ( set_a_filt_kk   ),  // config KK coefficient
  .cfg_pp_i    ( set_a_filt_pp   )   // config PP coefficient
);

red_pitaya_dfilt1 i_dfilt1_chb (
   // ADC
  .adc_clk_i   ( adc_clk_i       ),  // ADC clock
  .adc_rstn_i  ( adc_rstn_i      ),  // ADC reset - active low
  .adc_dat_i   ( adc_b_filt_in   ),  // ADC data
  .adc_dat_o   ( adc_b_filt_out  ),  // ADC data
   // configuration
  .cfg_aa_i    ( set_b_filt_aa   ),  // config AA coefficient
  .cfg_bb_i    ( set_b_filt_bb   ),  // config BB coefficient
  .cfg_kk_i    ( set_b_filt_kk   ),  // config KK coefficient
  .cfg_pp_i    ( set_b_filt_pp   )   // config PP coefficient
);

//---------------------------------------------------------------------------------
//  Decimate input data

reg  [ 14-1: 0] adc_a_dat     ;
reg  [ 14-1: 0] adc_b_dat     ;
reg  [ 32-1: 0] adc_a_sum     ;
reg  [ 32-1: 0] adc_b_sum     ;
reg  [ 32-1: 0] a_sum_in      ;
reg  [ 32-1: 0] b_sum_in      ;
reg  [ 32-1: 0] a_sum_uns     ;
reg  [ 32-1: 0] b_sum_uns     ;
reg  [ 32-1: 0] a_div_uns     ;
reg  [ 32-1: 0] b_div_uns     ;
reg  [ 17-1: 0] set_dec       ;
reg  [ 17-1: 0] adc_dec_cnt   ;
reg             set_avg_en    ;
reg             adc_dv        ;
reg             div_go        ;
wire            div_ok_a      ;
wire            div_ok_b      ;
reg             dat_got       ;
reg             div_dat_got   ;
reg  [ 32-1: 0] a_dat_div     ;
wire [ 32-1: 0] div_out_a     ;
reg  [ 32-1: 0] b_dat_div     ;
wire [ 32-1: 0] div_out_b     ;
reg             adc_dv_div    ;
reg  [ 34-1: 0] sign_sr_a     ;
reg             sign_curr_a   ;
reg  [ 34-1: 0] sign_sr_b     ;
reg             sign_curr_b   ;


divide #(

   .XDW(32)          , // mod(XDW, PIPE*GRAIN) == 0  !!!!!!!! x data width
   .XDWW(6)          , // ceil(log2(XDW)) x data width, width
   .YDW(17)          , //y data width
   .PIPE(2)          , // how many parallel pipes (1 is minimal)
   .GRAIN(1)         ,
   .RST_ACT_LVL(0)     //positive or negative reset
)
dec_avg_div_a
(
   .clk_i(adc_clk_i) ,
   .rst_i(adc_rstn_i),
   .x_i(a_sum_uns)   , // numerator (dividend) [ XDW-1: 0]
   .y_i(set_dec)     , // denominator (divisor)[ YDW-1: 0]   // Both input values must be unsigned !!!
   .dv_i(div_go)     , //ready to start division
   .q_o(div_out_a)   , // quotient [ XDW-1: 0]
   .dv_o(div_ok_a)     // result available
);

divide #(

   .XDW(32)          ,
   .XDWW(6)          ,
   .YDW(17)          ,
   .PIPE(2)          ,
   .GRAIN(1)         , 
   .RST_ACT_LVL(0)
)
dec_avg_div_b
(
   .clk_i(adc_clk_i) ,
   .rst_i(adc_rstn_i),
   .x_i(b_sum_uns)   ,
   .y_i(set_dec)     ,
   .dv_i(div_go)     ,
   .q_o(div_out_b)   ,
   .dv_o(div_ok_b)
);

always @(posedge adc_clk_i)
if (adc_rstn_i == 1'b0) begin
   div_go      <= 1'b0;
   dat_got     <= 1'b0;
   adc_dv_div  <= 1'b0;
   div_dat_got <= 1'b0;
   a_div_uns   <= 32'h0;
   b_div_uns   <= 32'h0;
   a_sum_uns   <= 32'h0;
   b_sum_uns   <= 32'h0;
   a_sum_in    <= 32'h0;
   b_sum_in    <= 32'h0;
   a_dat_div   <= 32'h0;
   b_dat_div   <= 32'h0;
   sign_curr_a <= 1'b0;
   sign_sr_a   <= 34'b0;
   sign_curr_b <= 1'b0;
   sign_sr_b   <= 34'b0;
end else begin
   sign_sr_a<={sign_sr_a[34-2:0],sign_curr_a}; // sign shift register
   sign_sr_b<={sign_sr_b[34-2:0],sign_curr_b};
   if(adc_dec_cnt >= set_dec && set_dec >= 17'd16) begin //save sign and sum 
      sign_curr_a <= adc_a_sum[32-1];
      a_sum_in    <= adc_a_sum;
      sign_curr_b <= adc_b_sum[32-1];
      b_sum_in    <= adc_b_sum;
      dat_got     <= 1'b1; //data was acquired
   end else
      dat_got     <= 1'b0;  
        
   if (dat_got) begin
      div_go <= 1'b1; // when input data is unsigned, start division
      if (sign_curr_a) //handle signs 
         a_sum_uns <= -a_sum_in; // division has about 33 cycles of latency, new data may be fed every 16 cycles
      else 
         a_sum_uns <=  a_sum_in;
      
      if (sign_curr_b) //handle signs 
         b_sum_uns <= -b_sum_in;
      else 
         b_sum_uns <=  b_sum_in;
   end else
      div_go <= 1'b0;

   if (div_ok_a || div_ok_b) begin // division finished
      div_dat_got <= 1'b1;    
      a_div_uns   <= div_out_a; //get unsigned output data  
      b_div_uns   <= div_out_b;   
   end else
      div_dat_got <= 1'b0;
   
   if(div_dat_got) begin
      adc_dv_div<=1'b1;
      if (sign_sr_a[34-1]) // handle signs after division
         a_dat_div <= -div_out_a;
      else 
         a_dat_div <=  div_out_a;

      if (sign_sr_b[34-1]) // handle signs after division
         b_dat_div <= -div_out_b;
      else 
         b_dat_div <=  div_out_b;
      
   end else
      adc_dv_div <= 1'b0;
end

wire dec_valid = (adc_dec_cnt >= set_dec);

always @(posedge adc_clk_i)
if (adc_rstn_i == 1'b0) begin
   adc_a_sum   <= 32'h0 ;
   adc_b_sum   <= 32'h0 ;
   adc_dec_cnt <= 17'h0 ;
   adc_dv      <=  1'b0 ;
end else begin
   if (dec_valid || adc_arm_do) begin // start again or arm
      adc_dec_cnt <= 17'h1    ;              
      adc_a_sum   <= $signed(adc_a_filt_out) ;
      adc_b_sum   <= $signed(adc_b_filt_out) ;
   end else begin
      adc_dec_cnt <= adc_dec_cnt + 17'h1 ;
      adc_a_sum   <= $signed(adc_a_sum) + $signed(adc_a_filt_out) ;
      adc_b_sum   <= $signed(adc_b_sum) + $signed(adc_b_filt_out) ;
   end

   case (set_dec & {17{set_avg_en}}) // allowed dec factors: 1,2,4,8; if 16 or greater, use divider
      17'h0     : begin adc_a_dat <= adc_a_filt_out;       adc_b_dat <= adc_b_filt_out;       adc_dv <= dec_valid;  end // if averaging is disabled
      17'h1     : begin adc_a_dat <= adc_a_sum[15+0 :  0]; adc_b_dat <= adc_b_sum[15+0 :  0]; adc_dv <= dec_valid;  end
      17'h2     : begin adc_a_dat <= adc_a_sum[15+1 :  1]; adc_b_dat <= adc_b_sum[15+1 :  1]; adc_dv <= dec_valid;  end
      17'h4     : begin adc_a_dat <= adc_a_sum[15+2 :  2]; adc_b_dat <= adc_b_sum[15+2 :  2]; adc_dv <= dec_valid;  end
      17'h8     : begin adc_a_dat <= adc_a_sum[15+3 :  3]; adc_b_dat <= adc_b_sum[15+3 :  3]; adc_dv <= dec_valid;  end
      17'd3, 
      17'd5, 
      17'd6,
      17'd7, 
      17'd9, 
      17'd10, 
      17'd11, 
      17'd12, 
      17'd13, 
      17'd14, 
      17'd15    : begin adc_a_dat <= adc_a_filt_out;       adc_b_dat <= adc_b_filt_out;       adc_dv <= dec_valid;  end // no division for any other decimation factor
      default   : begin adc_a_dat <= a_dat_div;            adc_b_dat <= b_dat_div;            adc_dv <= adc_dv_div; end
   endcase
end

//---------------------------------------------------------------------------------
//  ADC buffer RAM

reg   [  14-1: 0] adc_a_buf [0:(1<<RSZ)-1] ;
reg   [  14-1: 0] adc_b_buf [0:(1<<RSZ)-1] ;
reg   [  14-1: 0] adc_a_rd      ;
reg   [  14-1: 0] adc_b_rd      ;
reg   [ RSZ-1: 0] adc_wp        ;
reg   [ RSZ-1: 0] adc_raddr     ;
reg   [ RSZ-1: 0] adc_a_raddr   ;
reg   [ RSZ-1: 0] adc_b_raddr   ;
reg   [   4-1: 0] adc_rval      ;
wire              adc_rd_dv     ;
reg               adc_we        ;
reg               adc_we_keep   ;
reg               adc_trig      ;

reg   [ RSZ-1: 0] adc_wp_trig   ;
reg   [ RSZ-1: 0] adc_wp_cur    ;
reg   [  32-1: 0] set_dly       ;
reg   [  32-1: 0] adc_we_cnt    ;
reg   [  32-1: 0] adc_dly_cnt   ;
reg               adc_dly_do    ;
reg               adc_dly_end   ;
reg               adc_dly_end_reg;
reg               adc_trg_rd    ;
reg               adc_trg_rd_reg;
reg    [ 20-1: 0] set_deb_len   ; // debouncing length (glitch free time after a posedge)
wire              dec1    ;

assign dec1  = (set_dec==17'h1);

// Write
always @(posedge adc_clk_i) begin
   if (adc_rstn_i == 1'b0) begin
      adc_wp      <= {RSZ{1'b0}};
      adc_we      <=  1'b0      ;
      adc_wp_trig <= {RSZ{1'b0}};
      adc_wp_cur  <= {RSZ{1'b0}};
      adc_we_cnt  <= 32'h0      ;
      adc_dly_cnt <= 32'h0      ;
      adc_dly_do  <=  1'b0      ;
      adc_dly_end <=  1'b0      ;
      adc_dly_end_reg <= 1'b0   ;
      adc_trg_rd  <=  1'b0      ;
      adc_trg_rd_reg  <= 1'b0   ;
   end
   else begin
      if (adc_arm_do)
         adc_we <= 1'b1 ;
      else if (((adc_dly_do || adc_trig) && (adc_dly_cnt == {31'h0,dec1}) && ~adc_we_keep) || adc_rst_do) //delayed reached or reset
         adc_we <= 1'b0 ;

      // count how much data was written into the buffer before trigger
      if (adc_rst_do | adc_arm_do)
         adc_we_cnt <= 32'h0;
      if (adc_we & ~adc_dly_do & adc_dv & ~&adc_we_cnt)
         adc_we_cnt <= adc_we_cnt + 1;

      if (adc_rst_do)
         adc_wp <= {RSZ{1'b0}};
      else if (adc_we && adc_dv)
         adc_wp <= adc_wp + 1;

      if (adc_rst_do)
         adc_wp_trig <= {RSZ{1'b0}};
      else if (adc_trig && !adc_dly_do)
         adc_wp_trig <= adc_wp_cur; // save write pointer at trigger arrival

      if (adc_rst_do)
         adc_wp_cur <= {RSZ{1'b0}};
      else if (adc_we && adc_dv)
         adc_wp_cur <= adc_wp; // save current write pointer


      if (adc_trig)
         adc_dly_do  <= 1'b1;
      else if ((adc_dly_do && (adc_dly_cnt == {31'h0,dec1})) || adc_rst_do || adc_arm_do) //delayed reached or reset; delay is shortened by 1
         adc_dly_do  <= 1'b0;
      
      adc_dly_end_reg <= adc_dly_do; 
      
      if (adc_rst_do || adc_arm_do)
         adc_dly_end<=1'b0;
      else if (adc_dly_end_reg && ~adc_dly_do) //check if delay is over
         adc_dly_end<=1'b1; //register remains 1 until next arm or reset

      adc_trg_rd_reg<=adc_trig;
      if (~adc_trg_rd_reg && adc_trig) //check if trigger happenned
         adc_trg_rd<=1'b1; //register remains 1 until next arm or reset
      else if (adc_rst_do || adc_arm_do)
         adc_trg_rd<=1'b0;

      if ((adc_dly_do || adc_trig) && adc_we && adc_dv)
         adc_dly_cnt <= adc_dly_cnt - 1;
      else if (!adc_dly_do)
         adc_dly_cnt <= set_dly ;

   end
end

always @(posedge adc_clk_i) begin
   if (adc_we && adc_dv) begin
      adc_a_buf[adc_wp] <= adc_a_dat ;
      adc_b_buf[adc_wp] <= adc_b_dat ;
   end
end

// Read
always @(posedge adc_clk_i) begin
   if (adc_rstn_i == 1'b0)
      adc_rval <= 4'h0 ;
   else
      adc_rval <= {adc_rval[2:0], (sys_ren || sys_wen)};
end
assign adc_rd_dv = adc_rval[3];

always @(posedge adc_clk_i) begin
   adc_raddr   <= sys_addr[RSZ+1:2] ; // address synchronous to clock
   adc_a_raddr <= adc_raddr     ; // double register 
   adc_b_raddr <= adc_raddr     ; // otherwise memory corruption at reading
   adc_a_rd    <= adc_a_buf[adc_a_raddr] ;
   adc_b_rd    <= adc_b_buf[adc_b_raddr] ;
end




//---------------------------------------------------------------------------------
//
//  AXI CHA connection

reg  [ 32-1: 0] set_a_axi_start    ;
reg  [ 32-1: 0] set_a_axi_stop     ;
reg  [ 32-1: 0] set_a_axi_dly      ;
reg             set_a_axi_en       ;
reg  [ 32-1: 0] set_a_axi_trig     ;
reg  [ 32-1: 0] set_a_axi_cur      ;
reg             axi_a_we           ;
reg  [ 64-1: 0] axi_a_dat          ;
reg  [  2-1: 0] axi_a_dat_sel      ;
reg  [  1-1: 0] axi_a_dat_dv       ;
reg  [ 32-1: 0] axi_a_dly_cnt      ;
reg             axi_a_dly_do       ;
wire            axi_a_clr          ;
wire [ 32-1: 0] axi_a_cur_addr     ;

assign axi_a_clr = adc_rst_do ;


always @(posedge axi0_clk_o) begin
   if (axi0_rstn_o == 1'b0) begin
      axi_a_dat_sel <=  2'h0 ;
      axi_a_dat_dv  <=  1'b0 ;
      axi_a_dly_cnt <= 32'h0 ;
      axi_a_dly_do  <=  1'b0 ;
   end
   else begin
      if (adc_arm_do && set_a_axi_en)
         axi_a_we <= 1'b1 ;
      else if (((axi_a_dly_do || adc_trig) && (axi_a_dly_cnt == {31'h0,dec1})) || adc_rst_do) //delayed reached or reset
         axi_a_we <= 1'b0 ;

      if (adc_trig && axi_a_we)
         axi_a_dly_do  <= 1'b1 ;
      else if ((axi_a_dly_do && (axi_a_dly_cnt == {31'h0,dec1})) || axi_a_clr || adc_arm_do) //delayed reached or reset
         axi_a_dly_do  <= 1'b0 ;

      if ((axi_a_dly_do || adc_trig) && axi_a_we && adc_dv)
         axi_a_dly_cnt <= axi_a_dly_cnt - 1;
      else if (!axi_a_dly_do)
         axi_a_dly_cnt <= set_a_axi_dly ;

      if (axi_a_clr)
         axi_a_dat_sel <= 2'h0 ;
      else if (axi_a_we && adc_dv)
         axi_a_dat_sel <= axi_a_dat_sel + 2'h1 ;

      axi_a_dat_dv <= axi_a_we && (axi_a_dat_sel == 2'b11) && adc_dv ;
   end

   if (axi_a_we && adc_dv) begin
      if (axi_a_dat_sel == 2'b00) axi_a_dat[ 16-1:  0] <= $signed(adc_a_dat);
      if (axi_a_dat_sel == 2'b01) axi_a_dat[ 32-1: 16] <= $signed(adc_a_dat);
      if (axi_a_dat_sel == 2'b10) axi_a_dat[ 48-1: 32] <= $signed(adc_a_dat);
      if (axi_a_dat_sel == 2'b11) axi_a_dat[ 64-1: 48] <= $signed(adc_a_dat);
   end

   if (axi_a_clr)
      set_a_axi_trig <= {RSZ{1'b0}};
   else if (adc_trig && !axi_a_dly_do && axi_a_we)
      set_a_axi_trig <= {axi_a_cur_addr[32-1:3],axi_a_dat_sel,1'b0} ; // save write pointer at trigger arrival

   if (axi_a_clr)
      set_a_axi_cur <= set_a_axi_start ;
   else if (axi0_wvalid_o)
      set_a_axi_cur <= axi_a_cur_addr ;
end

axi_wr_fifo #(
  .DW  (  64    ), // data width (8,16,...,1024)
  .AW  (  32    ), // address width
  .FW  (   8    )  // address width of FIFO pointers
) i_wr0 (
   // global signals
  .axi_clk_i          (  axi0_clk_o        ), // global clock
  .axi_rstn_i         (  axi0_rstn_o       ), // global reset

   // Connection to AXI master
  .axi_waddr_o        (  axi0_waddr_o      ), // write address
  .axi_wdata_o        (  axi0_wdata_o      ), // write data
  .axi_wsel_o         (  axi0_wsel_o       ), // write byte select
  .axi_wvalid_o       (  axi0_wvalid_o     ), // write data valid
  .axi_wlen_o         (  axi0_wlen_o       ), // write burst length
  .axi_wfixed_o       (  axi0_wfixed_o     ), // write burst type (fixed / incremental)
  .axi_werr_i         (  axi0_werr_i       ), // write error
  .axi_wrdy_i         (  axi0_wrdy_i       ), // write ready

   // data and configuration
  .wr_data_i          (  axi_a_dat         ), // write data
  .wr_val_i           (  axi_a_dat_dv      ), // write data valid
  .ctrl_start_addr_i  (  set_a_axi_start   ), // range start address
  .ctrl_stop_addr_i   (  set_a_axi_stop    ), // range stop address
  .ctrl_trig_size_i   (  4'hF              ), // trigger level
  .ctrl_wrap_i        (  1'b1              ), // start from begining when reached stop
  .ctrl_clr_i         (  axi_a_clr         ), // clear / flush
  .stat_overflow_o    (                    ), // overflow indicator
  .stat_cur_addr_o    (  axi_a_cur_addr    ), // current write address
  .stat_write_data_o  (                    )  // write data indicator
);

assign axi0_clk_o  = adc_clk_i ;
assign axi0_rstn_o = adc_rstn_i;

//---------------------------------------------------------------------------------
//
//  AXI CHB connection

reg  [ 32-1: 0] set_b_axi_start    ;
reg  [ 32-1: 0] set_b_axi_stop     ;
reg  [ 32-1: 0] set_b_axi_dly      ;
reg             set_b_axi_en       ;
reg  [ 32-1: 0] set_b_axi_trig     ;
reg  [ 32-1: 0] set_b_axi_cur      ;
reg             axi_b_we           ;
reg  [ 64-1: 0] axi_b_dat          ;
reg  [  2-1: 0] axi_b_dat_sel      ;
reg  [  1-1: 0] axi_b_dat_dv       ;
reg  [ 32-1: 0] axi_b_dly_cnt      ;
reg             axi_b_dly_do       ;
wire            axi_b_clr          ;
wire [ 32-1: 0] axi_b_cur_addr     ;

assign axi_b_clr = adc_rst_do ;


always @(posedge axi1_clk_o) begin
   if (axi1_rstn_o == 1'b0) begin
      axi_b_dat_sel <=  2'h0 ;
      axi_b_dat_dv  <=  1'b0 ;
      axi_b_dly_cnt <= 32'h0 ;
      axi_b_dly_do  <=  1'b0 ;
   end
   else begin
      if (adc_arm_do && set_b_axi_en)
         axi_b_we <= 1'b1 ;
      else if (((axi_b_dly_do || adc_trig) && (axi_b_dly_cnt == {31'h0,dec1})) || adc_rst_do) //delayed reached or reset
         axi_b_we <= 1'b0 ;

      if (adc_trig && axi_b_we)
         axi_b_dly_do  <= 1'b1 ;
      else if ((axi_b_dly_do && (axi_b_dly_cnt == {31'h0,dec1})) || axi_b_clr || adc_arm_do) //delayed reached or reset
         axi_b_dly_do  <= 1'b0 ;

      if ((axi_b_dly_do || adc_trig) && axi_b_we && adc_dv)
         axi_b_dly_cnt <= axi_b_dly_cnt - 1;
      else if (!axi_b_dly_do)
         axi_b_dly_cnt <= set_b_axi_dly ;

      if (axi_b_clr)
         axi_b_dat_sel <= 2'h0 ;
      else if (axi_b_we && adc_dv)
         axi_b_dat_sel <= axi_b_dat_sel + 2'h1 ;

      axi_b_dat_dv <= axi_b_we && (axi_b_dat_sel == 2'b11) && adc_dv ;
   end

   if (axi_b_we && adc_dv) begin
      if (axi_b_dat_sel == 2'b00) axi_b_dat[ 16-1:  0] <= $signed(adc_b_dat);
      if (axi_b_dat_sel == 2'b01) axi_b_dat[ 32-1: 16] <= $signed(adc_b_dat);
      if (axi_b_dat_sel == 2'b10) axi_b_dat[ 48-1: 32] <= $signed(adc_b_dat);
      if (axi_b_dat_sel == 2'b11) axi_b_dat[ 64-1: 48] <= $signed(adc_b_dat);
   end

   if (axi_b_clr)
      set_b_axi_trig <= {RSZ{1'b0}};
   else if (adc_trig && !axi_b_dly_do && axi_b_we)
      set_b_axi_trig <= {axi_b_cur_addr[32-1:3],axi_b_dat_sel,1'b0} ; // save write pointer at trigger arrival

   if (axi_b_clr)
      set_b_axi_cur <= set_b_axi_start ;
   else if (axi1_wvalid_o)
      set_b_axi_cur <= axi_b_cur_addr ;
end

axi_wr_fifo #(
  .DW  (  64    ), // data width (8,16,...,1024)
  .AW  (  32    ), // address width
  .FW  (   8    )  // address width of FIFO pointers
) i_wr1 (
   // global signals
  .axi_clk_i          (  axi1_clk_o        ), // global clock
  .axi_rstn_i         (  axi1_rstn_o       ), // global reset

   // Connection to AXI master
  .axi_waddr_o        (  axi1_waddr_o      ), // write address
  .axi_wdata_o        (  axi1_wdata_o      ), // write data
  .axi_wsel_o         (  axi1_wsel_o       ), // write byte select
  .axi_wvalid_o       (  axi1_wvalid_o     ), // write data valid
  .axi_wlen_o         (  axi1_wlen_o       ), // write burst length
  .axi_wfixed_o       (  axi1_wfixed_o     ), // write burst type (fixed / incremental)
  .axi_werr_i         (  axi1_werr_i       ), // write error
  .axi_wrdy_i         (  axi1_wrdy_i       ), // write ready

   // data and configuration
  .wr_data_i          (  axi_b_dat         ), // write data
  .wr_val_i           (  axi_b_dat_dv      ), // write data valid
  .ctrl_start_addr_i  (  set_b_axi_start   ), // range start address
  .ctrl_stop_addr_i   (  set_b_axi_stop    ), // range stop address
  .ctrl_trig_size_i   (  4'hF              ), // trigger level
  .ctrl_wrap_i        (  1'b1              ), // start from begining when reached stop
  .ctrl_clr_i         (  axi_b_clr         ), // clear / flush
  .stat_overflow_o    (                    ), // overflow indicator
  .stat_cur_addr_o    (  axi_b_cur_addr    ), // current write address
  .stat_write_data_o  (                    )  // write data indicator
);

assign axi1_clk_o  = adc_clk_i ;
assign axi1_rstn_o = adc_rstn_i;

//---------------------------------------------------------------------------------
//  Trigger source selector

reg               adc_trig_ap      ;
reg               adc_trig_an      ;
reg               adc_trig_bp      ;
reg               adc_trig_bn      ;
reg               adc_trig_sw      ;
reg   [   4-1: 0] set_trig_src     ;
wire              ext_trig_p       ;
wire              ext_trig_n       ;
wire              asg_trig_p       ;
wire              asg_trig_n       ;

always @(posedge adc_clk_i)
if (adc_rstn_i == 1'b0) begin
   adc_arm_do    <= 1'b0 ;
   adc_rst_do    <= 1'b0 ;
   adc_trig_sw   <= 1'b0 ;
   set_trig_src  <= 4'h0 ;
   adc_trig      <= 1'b0 ;
end else begin
   adc_arm_do  <= sys_wen && (sys_addr[19:0]==20'h0) && sys_wdata[0] ; // SW ARM
   adc_rst_do  <= sys_wen && (sys_addr[19:0]==20'h0) && sys_wdata[1] ;
   adc_trig_sw <= sys_wen && (sys_addr[19:0]==20'h4) && (sys_wdata[3:0]==4'h1); // SW trigger

      if (sys_wen && (sys_addr[19:0]==20'h4))
         set_trig_src <= sys_wdata[3:0] ;
      else if (adc_dly_do || adc_trig || adc_rst_do) //delay reached or reset
         set_trig_src <= 4'h0 ;

   case (set_trig_src)
       4'd1 : adc_trig <= adc_trig_sw   ; // manual
       4'd2 : adc_trig <= CHN == 0 ? adc_trig_ap : trig_ch_i[0] ; // A ch rising edge
       4'd3 : adc_trig <= CHN == 0 ? adc_trig_an : trig_ch_i[1] ; // A ch falling edge
       4'd4 : adc_trig <= CHN == 0 ? adc_trig_bp : trig_ch_i[2] ; // B ch rising edge
       4'd5 : adc_trig <= CHN == 0 ? adc_trig_bn : trig_ch_i[3] ; // B ch falling edge
       4'd6 : adc_trig <= ext_trig_p    ; // external - rising edge
       4'd7 : adc_trig <= ext_trig_n    ; // external - falling edge
       4'd8 : adc_trig <= asg_trig_p    ; // ASG - rising edge
       4'd9 : adc_trig <= asg_trig_n    ; // ASG - falling edge
       4'd10: adc_trig <= CHN == 1 ? adc_trig_ap : trig_ch_i[0] ; // from the other two ADC channels: C ch rising edge
       4'd11: adc_trig <= CHN == 1 ? adc_trig_an : trig_ch_i[1] ; // from the other two ADC channels: C ch falling edge
       4'd12: adc_trig <= CHN == 1 ? adc_trig_bp : trig_ch_i[2] ; // from the other two ADC channels: D ch rising edge
       4'd13: adc_trig <= CHN == 1 ? adc_trig_bn : trig_ch_i[3] ; // from the other two ADC channels: D ch falling edge
    default : adc_trig <= 1'b0          ; 
   endcase
end

assign trig_ch_o = {adc_trig_bn, adc_trig_bp, adc_trig_an, adc_trig_ap};
//---------------------------------------------------------------------------------
//  Trigger created from input signal

reg  [  2-1: 0] adc_scht_ap  ;
reg  [  2-1: 0] adc_scht_an  ;
reg  [  2-1: 0] adc_scht_bp  ;
reg  [  2-1: 0] adc_scht_bn  ;
reg  [ 14-1: 0] set_a_tresh  ;
reg  [ 14-1: 0] set_a_treshp ;
reg  [ 14-1: 0] set_a_treshm ;
reg  [ 14-1: 0] set_b_tresh  ;
reg  [ 14-1: 0] set_b_treshp ;
reg  [ 14-1: 0] set_b_treshm ;
reg  [ 14-1: 0] set_a_hyst   ;
reg  [ 14-1: 0] set_b_hyst   ;

always @(posedge adc_clk_i)
if (adc_rstn_i == 1'b0) begin
   adc_scht_ap  <=  2'h0 ;
   adc_scht_an  <=  2'h0 ;
   adc_scht_bp  <=  2'h0 ;
   adc_scht_bn  <=  2'h0 ;
   adc_trig_ap  <=  1'b0 ;
   adc_trig_an  <=  1'b0 ;
   adc_trig_bp  <=  1'b0 ;
   adc_trig_bn  <=  1'b0 ;
end else begin
   set_a_treshp <= set_a_tresh + set_a_hyst ; // calculate positive
   set_a_treshm <= set_a_tresh - set_a_hyst ; // and negative treshold
   set_b_treshp <= set_b_tresh + set_b_hyst ;
   set_b_treshm <= set_b_tresh - set_b_hyst ;

   if (adc_dv) begin
           if ($signed(adc_a_dat) >= $signed(set_a_tresh ))      adc_scht_ap[0] <= 1'b1 ;  // treshold reached
      else if ($signed(adc_a_dat) <  $signed(set_a_treshm))      adc_scht_ap[0] <= 1'b0 ;  // wait until it goes under hysteresis
           if ($signed(adc_a_dat) <= $signed(set_a_tresh ))      adc_scht_an[0] <= 1'b1 ;  // treshold reached
      else if ($signed(adc_a_dat) >  $signed(set_a_treshp))      adc_scht_an[0] <= 1'b0 ;  // wait until it goes over hysteresis

           if ($signed(adc_b_dat) >= $signed(set_b_tresh ))      adc_scht_bp[0] <= 1'b1 ;
      else if ($signed(adc_b_dat) <  $signed(set_b_treshm))      adc_scht_bp[0] <= 1'b0 ;
           if ($signed(adc_b_dat) <= $signed(set_b_tresh ))      adc_scht_bn[0] <= 1'b1 ;
      else if ($signed(adc_b_dat) >  $signed(set_b_treshp))      adc_scht_bn[0] <= 1'b0 ;
   end

   adc_scht_ap[1] <= adc_scht_ap[0] ;
   adc_scht_an[1] <= adc_scht_an[0] ;
   adc_scht_bp[1] <= adc_scht_bp[0] ;
   adc_scht_bn[1] <= adc_scht_bn[0] ;

   adc_trig_ap <= adc_scht_ap[0] && !adc_scht_ap[1] ; // make 1 cyc pulse 
   adc_trig_an <= adc_scht_an[0] && !adc_scht_an[1] ;
   adc_trig_bp <= adc_scht_bp[0] && !adc_scht_bp[1] ;
   adc_trig_bn <= adc_scht_bn[0] && !adc_scht_bn[1] ;
end

//---------------------------------------------------------------------------------
//  External trigger

reg  [  3-1: 0] ext_trig_in    ;
reg  [  2-1: 0] ext_trig_dp    ;
reg  [  2-1: 0] ext_trig_dn    ;
reg  [ 20-1: 0] ext_trig_debp  ;
reg  [ 20-1: 0] ext_trig_debn  ;
reg  [  3-1: 0] asg_trig_in    ;
reg  [  2-1: 0] asg_trig_dp    ;
reg  [  2-1: 0] asg_trig_dn    ;
reg  [ 20-1: 0] asg_trig_debp  ;
reg  [ 20-1: 0] asg_trig_debn  ;

always @(posedge adc_clk_i)
if (adc_rstn_i == 1'b0) begin
   ext_trig_in   <=  3'h0 ;
   ext_trig_dp   <=  2'h0 ;
   ext_trig_dn   <=  2'h0 ;
   ext_trig_debp <= 20'h0 ;
   ext_trig_debn <= 20'h0 ;
   asg_trig_in   <=  3'h0 ;
   asg_trig_dp   <=  2'h0 ;
   asg_trig_dn   <=  2'h0 ;
   asg_trig_debp <= 20'h0 ;
   asg_trig_debn <= 20'h0 ;
end else begin
   //----------- External trigger
   // synchronize FFs
   ext_trig_in <= {ext_trig_in[1:0],trig_ext_i} ;

   // look for input changes
   if ((ext_trig_debp == 20'h0) && (ext_trig_in[1] && !ext_trig_in[2]))
      ext_trig_debp <= set_deb_len ; // ~0.5ms
   else if (ext_trig_debp != 20'h0)
      ext_trig_debp <= ext_trig_debp - 20'd1 ;

   if ((ext_trig_debn == 20'h0) && (!ext_trig_in[1] && ext_trig_in[2]))
      ext_trig_debn <= set_deb_len ; // ~0.5ms
   else if (ext_trig_debn != 20'h0)
      ext_trig_debn <= ext_trig_debn - 20'd1 ;

   // update output values
   ext_trig_dp[1] <= ext_trig_dp[0] ;
   if (ext_trig_debp == 20'h0)
      ext_trig_dp[0] <= ext_trig_in[1] ;

   ext_trig_dn[1] <= ext_trig_dn[0] ;
   if (ext_trig_debn == 20'h0)
      ext_trig_dn[0] <= ext_trig_in[1] ;

   //----------- ASG trigger
   // synchronize FFs
   asg_trig_in <= {asg_trig_in[1:0],trig_asg_i} ;

   // look for input changes
   if ((asg_trig_debp == 20'h0) && (asg_trig_in[1] && !asg_trig_in[2]))
      asg_trig_debp <= set_deb_len ; // ~0.5ms
   else if (asg_trig_debp != 20'h0)
      asg_trig_debp <= asg_trig_debp - 20'd1 ;

   if ((asg_trig_debn == 20'h0) && (!asg_trig_in[1] && asg_trig_in[2]))
      asg_trig_debn <= set_deb_len ; // ~0.5ms
   else if (asg_trig_debn != 20'h0)
      asg_trig_debn <= asg_trig_debn - 20'd1 ;

   // update output values
   asg_trig_dp[1] <= asg_trig_dp[0] ;
   if (asg_trig_debp == 20'h0)
      asg_trig_dp[0] <= asg_trig_in[1] ;

   asg_trig_dn[1] <= asg_trig_dn[0] ;
   if (asg_trig_debn == 20'h0)
      asg_trig_dn[0] <= asg_trig_in[1] ;
end

assign ext_trig_p = (ext_trig_dp == 2'b01) ;
assign ext_trig_n = (ext_trig_dn == 2'b10) ;
assign asg_trig_p = (asg_trig_dp == 2'b01) ;
assign asg_trig_n = (asg_trig_dn == 2'b10) ;

//---------------------------------------------------------------------------------
//  System bus connection

always @(posedge adc_clk_i)
if (adc_rstn_i == 1'b0) begin
   adc_we_keep   <=   1'b0      ;
   set_a_tresh   <=  14'd5000   ;
   set_b_tresh   <= -14'd5000   ;
   set_dly       <=  32'd0      ;
   set_dec       <=  17'd1      ;
   set_a_hyst    <=  14'd20     ;
   set_b_hyst    <=  14'd20     ;
   set_avg_en    <=   1'b1      ;
   set_a_filt_aa <=  18'h0      ;
   set_a_filt_bb <=  25'h0      ;
   set_a_filt_kk <=  25'hFFFFFF ;
   set_a_filt_pp <=  25'h0      ;
   set_b_filt_aa <=  18'h0      ;
   set_b_filt_bb <=  25'h0      ;
   set_b_filt_kk <=  25'hFFFFFF ;
   set_b_filt_pp <=  25'h0      ;
   set_deb_len   <=  20'd62500  ;
   set_a_axi_en  <=   1'b0      ;
   set_b_axi_en  <=   1'b0      ;
end else begin
   if (sys_wen) begin
      if (sys_addr[19:0]==20'h00)   adc_we_keep   <= sys_wdata[     3] ;

      if (sys_addr[19:0]==20'h08)   set_a_tresh   <= sys_wdata[14-1:0] ;
      if (sys_addr[19:0]==20'h0C)   set_b_tresh   <= sys_wdata[14-1:0] ;
      if (sys_addr[19:0]==20'h10)   set_dly       <= sys_wdata[32-1:0] ;
      if (sys_addr[19:0]==20'h14)   set_dec       <= sys_wdata[17-1:0] ;
      if (sys_addr[19:0]==20'h20)   set_a_hyst    <= sys_wdata[14-1:0] ;
      if (sys_addr[19:0]==20'h24)   set_b_hyst    <= sys_wdata[14-1:0] ;
      if (sys_addr[19:0]==20'h28)   set_avg_en    <= sys_wdata[     0] ;

      if (sys_addr[19:0]==20'h30)   set_a_filt_aa <= sys_wdata[18-1:0] ;
      if (sys_addr[19:0]==20'h34)   set_a_filt_bb <= sys_wdata[25-1:0] ;
      if (sys_addr[19:0]==20'h38)   set_a_filt_kk <= sys_wdata[25-1:0] ;
      if (sys_addr[19:0]==20'h3C)   set_a_filt_pp <= sys_wdata[25-1:0] ;
      if (sys_addr[19:0]==20'h40)   set_b_filt_aa <= sys_wdata[18-1:0] ;
      if (sys_addr[19:0]==20'h44)   set_b_filt_bb <= sys_wdata[25-1:0] ;
      if (sys_addr[19:0]==20'h48)   set_b_filt_kk <= sys_wdata[25-1:0] ;
      if (sys_addr[19:0]==20'h4C)   set_b_filt_pp <= sys_wdata[25-1:0] ;

      if (sys_addr[19:0]==20'h50)   set_a_axi_start <= sys_wdata[32-1:0] ;
      if (sys_addr[19:0]==20'h54)   set_a_axi_stop  <= sys_wdata[32-1:0] ;
      if (sys_addr[19:0]==20'h58)   set_a_axi_dly   <= sys_wdata[32-1:0] ;
      if (sys_addr[19:0]==20'h5C)   set_a_axi_en    <= sys_wdata[     0] ;

      if (sys_addr[19:0]==20'h70)   set_b_axi_start <= sys_wdata[32-1:0] ;
      if (sys_addr[19:0]==20'h74)   set_b_axi_stop  <= sys_wdata[32-1:0] ;
      if (sys_addr[19:0]==20'h78)   set_b_axi_dly   <= sys_wdata[32-1:0] ;
      if (sys_addr[19:0]==20'h7C)   set_b_axi_en    <= sys_wdata[     0] ;

      if (sys_addr[19:0]==20'h90)   set_deb_len <= sys_wdata[20-1:0] ;
   end
end

wire sys_en;
assign sys_en = sys_wen | sys_ren;

always @(posedge adc_clk_i)
if (adc_rstn_i == 1'b0) begin
   sys_err <= 1'b0 ;
   sys_ack <= 1'b0 ;
end else begin
   sys_err <= 1'b0 ;

   casez (sys_addr[19:0])
     20'h00000 : begin sys_ack <= sys_en;          sys_rdata <= {{32- 5{1'b0}}, adc_dly_end               // acquisition delay is over
                                                                              , adc_we_keep               // do not disarm on 
                                                                              , adc_trg_rd                // trigger status
                                                                              , 1'b0                      // reset
                                                                              , adc_we}             ; end // arm

     20'h00004 : begin sys_ack <= sys_en;          sys_rdata <= {{32- 4{1'b0}}, set_trig_src}       ; end 

     20'h00008 : begin sys_ack <= sys_en;          sys_rdata <= {{32-14{1'b0}}, set_a_tresh}        ; end
     20'h0000C : begin sys_ack <= sys_en;          sys_rdata <= {{32-14{1'b0}}, set_b_tresh}        ; end
     20'h00010 : begin sys_ack <= sys_en;          sys_rdata <= {               set_dly}            ; end
     20'h00014 : begin sys_ack <= sys_en;          sys_rdata <= {{32-17{1'b0}}, set_dec}            ; end

     20'h00018 : begin sys_ack <= sys_en;          sys_rdata <= {{32-RSZ{1'b0}}, adc_wp_cur}        ; end
     20'h0001C : begin sys_ack <= sys_en;          sys_rdata <= {{32-RSZ{1'b0}}, adc_wp_trig}       ; end

     20'h00020 : begin sys_ack <= sys_en;          sys_rdata <= {{32-14{1'b0}}, set_a_hyst}         ; end
     20'h00024 : begin sys_ack <= sys_en;          sys_rdata <= {{32-14{1'b0}}, set_b_hyst}         ; end

     20'h00028 : begin sys_ack <= sys_en;          sys_rdata <= {{32- 1{1'b0}}, set_avg_en}         ; end

     20'h0002C : begin sys_ack <= sys_en;          sys_rdata <=                 adc_we_cnt          ; end

     20'h00030 : begin sys_ack <= sys_en;          sys_rdata <= {{32-18{1'b0}}, set_a_filt_aa}      ; end
     20'h00034 : begin sys_ack <= sys_en;          sys_rdata <= {{32-25{1'b0}}, set_a_filt_bb}      ; end
     20'h00038 : begin sys_ack <= sys_en;          sys_rdata <= {{32-25{1'b0}}, set_a_filt_kk}      ; end
     20'h0003C : begin sys_ack <= sys_en;          sys_rdata <= {{32-25{1'b0}}, set_a_filt_pp}      ; end
     20'h00040 : begin sys_ack <= sys_en;          sys_rdata <= {{32-18{1'b0}}, set_b_filt_aa}      ; end
     20'h00044 : begin sys_ack <= sys_en;          sys_rdata <= {{32-25{1'b0}}, set_b_filt_bb}      ; end
     20'h00048 : begin sys_ack <= sys_en;          sys_rdata <= {{32-25{1'b0}}, set_b_filt_kk}      ; end
     20'h0004C : begin sys_ack <= sys_en;          sys_rdata <= {{32-25{1'b0}}, set_b_filt_pp}      ; end

     20'h00050 : begin sys_ack <= sys_en;          sys_rdata <=                 set_a_axi_start     ; end
     20'h00054 : begin sys_ack <= sys_en;          sys_rdata <=                 set_a_axi_stop      ; end
     20'h00058 : begin sys_ack <= sys_en;          sys_rdata <=                 set_a_axi_dly       ; end
     20'h0005C : begin sys_ack <= sys_en;          sys_rdata <= {{32- 1{1'b0}}, set_a_axi_en}       ; end
     20'h00060 : begin sys_ack <= sys_en;          sys_rdata <=                 set_a_axi_trig      ; end
     20'h00064 : begin sys_ack <= sys_en;          sys_rdata <=                 set_a_axi_cur       ; end

     20'h00070 : begin sys_ack <= sys_en;          sys_rdata <=                 set_b_axi_start     ; end
     20'h00074 : begin sys_ack <= sys_en;          sys_rdata <=                 set_b_axi_stop      ; end
     20'h00078 : begin sys_ack <= sys_en;          sys_rdata <=                 set_b_axi_dly       ; end
     20'h0007C : begin sys_ack <= sys_en;          sys_rdata <= {{32- 1{1'b0}}, set_b_axi_en}       ; end
     20'h00080 : begin sys_ack <= sys_en;          sys_rdata <=                 set_b_axi_trig      ; end
     20'h00084 : begin sys_ack <= sys_en;          sys_rdata <=                 set_b_axi_cur       ; end

     20'h00090 : begin sys_ack <= sys_en;          sys_rdata <= {{32-20{1'b0}}, set_deb_len}        ; end

     20'h1???? : begin sys_ack <= adc_rd_dv;       sys_rdata <= {16'h0, 2'h0,adc_a_rd}              ; end
     20'h2???? : begin sys_ack <= adc_rd_dv;       sys_rdata <= {16'h0, 2'h0,adc_b_rd}              ; end

       default : begin sys_ack <= sys_en;          sys_rdata <=  32'h0                              ; end
   endcase
end

endmodule
