HorvatMa/RedPitaya_scan/vivado/sources_1/imports/classic/rtl/classic/red_pitaya_asg_ch.v

/**
 * $Id: red_pitaya_asg_ch.v 1271 2014-02-25 12:32:34Z matej.oblak $
 *
 * @brief Red Pitaya ASG submodule. Holds table and FSM for one channel.
 *
 * @Author Matej Oblak
 *
 * (c) Red Pitaya  http://www.redpitaya.com
 *
 * This part of code is written in Verilog hardware description language (HDL).
 * Please visit http://en.wikipedia.org/wiki/Verilog
 * for more details on the language used herein.
 */

/**
 * GENERAL DESCRIPTION:
 *
 * Arbitrary signal generator takes data stored in buffer and sends them to DAC.
 *
 *
 *                /-----\         /--------\
 *   SW --------> | BUF | ------> | kx + o | ---> DAC DAT
 *          |     \-----/         \--------/
 *          |        ^
 *          |        |
 *          |     /-----\
 *          ----> |     |
 *                | FSM | ------> trigger notification
 *   trigger ---> |     |
 *                \-----/
 *
 *
 * Submodule for ASG which hold buffer data and control registers for one channel.
 * 
 */

module red_pitaya_asg_ch #(
   parameter RSZ = 14
)(
   // DAC
   output reg [ 14-1: 0] dac_o           ,  //!< dac data output
   input                 dac_clk_i       ,  //!< dac clock
   input                 dac_rstn_i      ,  //!< dac reset - active low
   // trigger
   input                 trig_sw_i       ,  //!< software trigger
   input                 trig_ext_i      ,  //!< external trigger
   input      [  3-1: 0] trig_src_i      ,  //!< trigger source selector
   output                trig_done_o     ,  //!< trigger event
   // buffer ctrl
   input                 buf_we_i        ,  //!< buffer write enable
   input      [ 14-1: 0] buf_addr_i      ,  //!< buffer address
   input      [ 14-1: 0] buf_wdata_i     ,  //!< buffer write data
   output reg [ 14-1: 0] buf_rdata_o     ,  //!< buffer read data
   output reg [RSZ-1: 0] buf_rpnt_o      ,  //!< buffer current read pointer
   // configuration
   input     [RSZ+15: 0] set_size_i      ,  //!< set table data size
   input     [RSZ+15: 0] set_step_i      ,  //!< set pointer step
   input     [  32-1: 0] set_step_lo_i   ,  //!< set pointer step, low frequency
   input     [RSZ+15: 0] set_ofs_i       ,  //!< set reset offset
   input                 set_rst_i       ,  //!< set FSM to reset
   input                 set_once_i      ,  //!< set only once  -- not used
   input                 set_wrap_i      ,  //!< set wrap enable
   input     [  14-1: 0] set_amp_i       ,  //!< set amplitude scale
   input     [  14-1: 0] set_dc_i        ,  //!< set output offset
   input     [  14-1: 0] set_last_i      ,  //!< set final value in burst
   input                 set_zero_i      ,  //!< set output to zero
   input     [  16-1: 0] set_ncyc_i      ,  //!< set number of cycle
   input     [  16-1: 0] set_rnum_i      ,  //!< set number of repetitions
   input     [  32-1: 0] set_rdly_i      ,  //!< set delay between repetitions
   input                 set_rgate_i        //!< set external gated repetition
);

//---------------------------------------------------------------------------------
//
//  DAC buffer RAM

localparam PNT_SIZE = RSZ+16+32;

reg   [  14-1: 0] dac_buf [0:(1<<RSZ)-1] ;
reg   [  14-1: 0] dac_rd    ;
reg   [  14-1: 0] dac_rdat  ;

reg   [ RSZ-1: 0] dac_rp    ;
reg   [PNT_SIZE-1: 0] dac_pnt   ; // read pointer
reg   [PNT_SIZE-1: 0] dac_pntp  ; // previour read pointer
wire  [PNT_SIZE  : 0] dac_npnt  ; // next read pointer
wire  [PNT_SIZE  : 0] dac_npnt_sub ;
wire              dac_npnt_sub_neg;

reg   [  16-1: 0] cyc_cnt   ;
reg signed  [  28-1: 0] dac_mult  ;
reg signed  [  15-1: 0] dac_sum   ;

reg               lastval;
reg   [   5-1: 0] lastval_sr;
reg   [   5-1: 0] zero_sr;

wire              not_burst;

assign not_burst = (&(~set_ncyc_i)) && (&(~set_rnum_i));

// read
always @(posedge dac_clk_i)
begin
   buf_rpnt_o <= dac_pnt[PNT_SIZE-1:16+32];
   dac_rp     <= dac_pnt[PNT_SIZE-1:16+32];
   dac_rd     <= dac_buf[dac_rp] ;
   dac_rdat   <= dac_rd ;  // improve timing
end

always @(posedge dac_clk_i) // shift regs are needed because of processing path delay
begin
   lastval_sr <= {lastval_sr[3:0], lastval   };
   zero_sr    <= {zero_sr[3:0]   , set_zero_i};
end

// write
always @(posedge dac_clk_i)
if (buf_we_i)  dac_buf[buf_addr_i] <= buf_wdata_i[14-1:0] ;

// read-back
always @(posedge dac_clk_i)
buf_rdata_o <= dac_buf[buf_addr_i] ;

// scale and offset
always @(posedge dac_clk_i)
begin
   dac_mult <= $signed(dac_rdat) * $signed({1'b0,set_amp_i}) ;
   dac_sum  <= $signed(dac_mult[28-1:13]) + $signed(set_dc_i) ;

   // saturation
   if (set_zero_i || |zero_sr)  
      dac_o <= 14'h0;
   else if (lastval || |lastval_sr) //on last value in burst send user specified last value
      dac_o <= set_last_i;
   else 
      dac_o <= ^dac_sum[15-1:15-2] ? {dac_sum[15-1], {13{~dac_sum[15-1]}}} : dac_sum[13:0];

end

//---------------------------------------------------------------------------------
//
//  read pointer & state machine

reg              trig_in      ;
wire             ext_trig_p   ;
wire             ext_trig_n   ;

reg  [  16-1: 0] rep_cnt      ;
reg  [  32-1: 0] dly_cnt      ;
reg  [   8-1: 0] dly_tick     ;

reg              dac_do       ;
reg  [   5-1: 0] dac_do_dlysr ;
reg              dac_rep      ;
wire             dac_trig     ;
reg              dac_trigr    ;

always @(posedge dac_clk_i)
begin 
   dac_do_dlysr[0]   <= dac_do;
   dac_do_dlysr[4:1] <= dac_do_dlysr[3:0];
end

always @(posedge dac_clk_i)
begin 
   if (dac_rstn_i == 1'b0)
      lastval <= 1'b0;
   else begin
      if (dac_do_dlysr[4:3] == 2'b10) // negative edge of dly_do, delayed for 4 cycles
         lastval <= 1'b1;
      else if ((lastval && dly_cnt == 'd0 && (|rep_cnt || (trig_in && !dac_do)))  || set_zero_i || set_rst_i || not_burst) // release from last value when new cycle starts or a set_zero is written. After final cycle, stay on lastval. also resets if reset is set or continous mode is selected.
         lastval <= 1'b0; // reset from lastval when a new trigger arrives
   end
end

// state machine
always @(posedge dac_clk_i) begin
   if (dac_rstn_i == 1'b0) begin
      cyc_cnt   <= 16'h0 ;
      rep_cnt   <= 16'h0 ;
      dly_cnt   <= 32'h0 ;
      dly_tick  <=  8'h0 ;
      dac_do    <=  1'b0 ;
      dac_rep   <=  1'b0 ;
      trig_in   <=  1'b0 ;
      dac_pntp  <= {PNT_SIZE{1'b0}} ;
      dac_trigr <=  1'b0 ;
   end
   else begin
      // make 1us tick
      if (dac_do || (dly_tick == 8'd124))
         dly_tick <= 8'h0 ;
      else
         dly_tick <= dly_tick + 8'h1 ;

      // delay between repetitions 
      if (set_rst_i || dac_do)
         dly_cnt <= set_rdly_i ;
      else if (|dly_cnt && (dly_tick == 8'd124))
         dly_cnt <= dly_cnt - 32'h1 ;

      // repetitions counter
      if (trig_in && !dac_do)
         rep_cnt <= set_rnum_i;
      else if (!set_rgate_i && (|rep_cnt && dac_rep && (dac_trig && !dac_do)) && (set_rnum_i != 16'hffff)) // only substract at the end of a cycle; 16'hffff is infinite pulses
         rep_cnt <= rep_cnt - 16'h1 ;
      else if (set_rgate_i && ((!trig_ext_i && trig_src_i==3'd2) || (trig_ext_i && trig_src_i==3'd3)))
         rep_cnt <= 16'h0 ;

      // count number of table read cycles
      dac_pntp  <= dac_pnt;
      dac_trigr <= dac_trig; // ignore trigger when count
      if (dac_trig)
         cyc_cnt <= set_ncyc_i ;
      else if (!dac_trigr && |cyc_cnt && ({1'b0,dac_pntp} > {1'b0,dac_pnt}))
         cyc_cnt <= cyc_cnt - 16'h1 ;

      // trigger arrived
      case (trig_src_i)
          3'd1 : trig_in <= trig_sw_i   ; // sw
          3'd2 : trig_in <= ext_trig_p  ; // external positive edge
          3'd3 : trig_in <= ext_trig_n  ; // external negative edge
       default : trig_in <= 1'b0        ;
      endcase

      // in cycle mode
      if (dac_trig && !set_rst_i)
         dac_do <= 1'b1 ;
      else if (set_rst_i || ((cyc_cnt==16'h1) && ~dac_npnt_sub_neg) )
         dac_do <= 1'b0 ;

      // in repetition mode
      if (dac_trig && !set_rst_i)
         dac_rep <= 1'b1 ;
      else if (set_rst_i || (rep_cnt==16'h0))
         dac_rep <= 1'b0 ;
   end
end

assign dac_trig = (!dac_rep && trig_in) || (dac_rep && |rep_cnt && (dly_cnt == 32'h0)) ;

assign dac_npnt_sub = dac_npnt - {1'b0,set_size_i,32'h0} - 1;
assign dac_npnt_sub_neg = dac_npnt_sub[PNT_SIZE];

// read pointer logic
always @(posedge dac_clk_i)
if (dac_rstn_i == 1'b0) begin
   dac_pnt  <= {PNT_SIZE{1'b0}};
end else begin
   if (set_rst_i || (dac_trig && !dac_do)) // manual reset or start
      dac_pnt <= {set_ofs_i,32'h0};
   else if (dac_do) begin
      if (~dac_npnt_sub_neg)  dac_pnt <= set_wrap_i ? dac_npnt_sub : {set_ofs_i,32'h0}; // wrap or go to start
      else                    dac_pnt <= dac_npnt[PNT_SIZE-1:0]; // normal increase
   end
end

assign dac_npnt = dac_pnt + {set_step_i,set_step_lo_i};
assign trig_done_o = !dac_rep && trig_in;

//---------------------------------------------------------------------------------
//
//  External trigger

reg  [  3-1: 0] ext_trig_in    ;
reg  [  2-1: 0] ext_trig_dp    ;
reg  [  2-1: 0] ext_trig_dn    ;
reg  [ 20-1: 0] ext_trig_debp  ;
reg  [ 20-1: 0] ext_trig_debn  ;

always @(posedge dac_clk_i) begin
   if (dac_rstn_i == 1'b0) begin
      ext_trig_in   <=  3'h0 ;
      ext_trig_dp   <=  2'h0 ;
      ext_trig_dn   <=  2'h0 ;
      ext_trig_debp <= 20'h0 ;
      ext_trig_debn <= 20'h0 ;
   end
   else begin
      //----------- External trigger
      // synchronize FFs
      ext_trig_in <= {ext_trig_in[1:0],trig_ext_i} ;

      // look for input changes
      if ((ext_trig_debp == 20'h0) && (ext_trig_in[1] && !ext_trig_in[2]))
         ext_trig_debp <= 20'd62500 ; // ~0.5ms
      else if (ext_trig_debp != 20'h0)
         ext_trig_debp <= ext_trig_debp - 20'd1 ;

      if ((ext_trig_debn == 20'h0) && (!ext_trig_in[1] && ext_trig_in[2]))
         ext_trig_debn <= 20'd62500 ; // ~0.5ms
      else if (ext_trig_debn != 20'h0)
         ext_trig_debn <= ext_trig_debn - 20'd1 ;

      // update output values
      ext_trig_dp[1] <= ext_trig_dp[0] ;
      if (ext_trig_debp == 20'h0)
         ext_trig_dp[0] <= ext_trig_in[1] ;

      ext_trig_dn[1] <= ext_trig_dn[0] ;
      if (ext_trig_debn == 20'h0)
         ext_trig_dn[0] <= ext_trig_in[1] ;
   end
end

assign ext_trig_p = (ext_trig_dp == 2'b01) ;
assign ext_trig_n = (ext_trig_dn == 2'b10) ;

endmodule
