HorvatMa/RedPitaya_scan/vivado/sources_1/imports/classic/rtl/axi4_slave.sv

/**
 * $Id: axi.slave.v 961 2014-01-21 11:40:39Z matej.oblak $
 *
 * @brief Red Pitaya symplified AXI slave.
 *
 * @Author Matej Oblak
 *
 * (c) Red Pitaya  http://www.redpitaya.com
 *
 * This part of code is written in Verilog hardware description language (HDL).
 * Please visit http://en.wikipedia.org/wiki/Verilog
 * for more details on the language used herein.
 */



/**
 * GENERAL DESCRIPTION:
 *
 * AXI slave used also for simple bus master.
 *
 *
 *                     /------\
 *   WR ADDRESS  ----> |  WR  |
 *   WR DATA     ----> |      | ----------- 
 *   WR RESPONSE <---- |  CH  |            |
 *                     \------/       /--------\
 *                                    | SIMPLE | ---> WR/RD ADDRRESS
 *   AXI                              |        | ---> WR DATA
 *                                    |   RP   | <--- RD DATA
 *                                    |  BUS   | <--- ACKNOWLEDGE
 *                     /------\       \--------/
 *   RD ADDRESS  ----> |  RD  |            |
 *   RD DATA     <---- |  CH  | -----------
 *                     \------/
 *
 *
 * Because AXI bus is quite complex simplier bus was created.
 * 
 * It combines write and read channel, where write has bigger priority. Command
 * is then send forward to red pitaya bus. When wite or read acknowledge is
 * received AXI response is created and new AXI is accepted.
 *
 * To prevent AXI lockups because no response is received, this slave creates its
 * own after 32 cycles (ack_cnt).
 * 
 */

module axi4_slave #(
  int unsigned DW =  64, // data width (8,16,...,1024)
  int unsigned AW =  32, // address width
  int unsigned IW =   8, // ID width
  int unsigned SW = DW >> 3  // select width - 1 bit for every data byte
)(
  // AXI MM
  `ifdef SYNC
    axi4_if.s    axi_in,
  `else
    axi4_if.s    axi,
  `endif
  // system read/write channel
  sys_bus_if.m bus
);

//---------------------------------------------------------------------------------
//  AXI slave Module
//---------------------------------------------------------------------------------

logic           ack      ;
logic [ 6-1: 0] ack_cnt  ;

logic           rd_do    ;
logic [IW-1: 0] rd_arid  ;
logic [AW-1: 0] rd_araddr;
logic           rd_error ;
logic           rd_errorw;

logic           wr_do    ;
logic [IW-1: 0] wr_awid  ;
logic [AW-1: 0] wr_awaddr;
logic [IW-1: 0] wr_wid   ;
logic [DW-1: 0] wr_wdata ;
logic           wr_error ;
logic           wr_errorw;

logic           xx_do;

`ifdef SYNC
axi4_if #(.DW (32), .AW (32), .IW (12), .LW (8)) axi (.ACLK (axi_in.ACLK), .ARESETn (axi_in.ARESETn));
axi4_sync sync (
.axi_i(axi_in),
.axi_o(axi)
);
`endif


// access cycle in progress
assign xx_do = rd_do | wr_do;

// check if access type is supported
assign wr_errorw = (axi.AWLEN != 4'h0) | ~((axi.AWSIZE == 3'b010) | (axi.AWSIZE == 3'b001)); // error if write burst and more/less than 4B transfer
assign rd_errorw = (axi.ARLEN != 4'h0) | ~((axi.ARSIZE == 3'b010) | (axi.ARSIZE == 3'b001)); // error if read  burst and more/less than 4B transfer

////////////////////////////////////////////////////////////////////////////////
// write access
////////////////////////////////////////////////////////////////////////////////

always_ff @(posedge axi.ACLK)
if (~axi.ARESETn) begin
   rd_do    <= 1'b0;
   rd_error <= 1'b0;
end else begin
   // accept just one read request - write has priority
   if      (axi.ARVALID & ~rd_do & ~axi.AWVALID & ~wr_do)  rd_do <= 1'b1;
   else if (axi.RREADY  &  rd_do & ack)                    rd_do <= 1'b0;
   // latch ID and address
   if (axi.ARVALID & axi.ARREADY) begin
      rd_arid   <= axi.ARID  ;
      rd_araddr <= axi.ARADDR;
      rd_error  <= rd_errorw ;
   end
end

assign axi.AWREADY = !wr_do && !rd_do;
assign axi.WREADY  = (wr_do && axi.WVALID) || (wr_errorw && axi.WVALID);
assign axi.BID     = wr_awid;

always_ff @(posedge axi.ACLK)
if (~axi.ARESETn) begin
   axi.BVALID  <= 1'b0;
   axi.BRESP   <= 2'h0;
end else begin
   axi.BVALID  <= wr_do && ack  ;
   axi.BRESP   <= {(wr_error || ack_cnt[5]),1'b0} ;  // 2'b10 SLVERR    2'b00 OK
end

////////////////////////////////////////////////////////////////////////////////
// read access
////////////////////////////////////////////////////////////////////////////////

always_ff @(posedge axi.ACLK)
if (~axi.ARESETn) begin
   wr_do    <= 1'b0;
   wr_error <= 1'b0;
end else begin
   // accept just one write request - if idle
   if      (axi.AWVALID & ~wr_do & ~rd_do)  wr_do <= 1'b1;
   else if (axi.BREADY  &  wr_do & ack)     wr_do <= 1'b0;
   // latch ID and address
   if (axi.AWVALID & axi.AWREADY) begin
      wr_awid   <= axi.AWID  ;
      wr_awaddr <= axi.AWADDR;
      wr_error  <= wr_errorw ;
   end
   // latch ID and write data
   if (axi.WVALID && wr_do) begin
      wr_wid    <= axi.WID  ;
      wr_wdata  <= axi.WDATA;
   end
end

assign axi.ARREADY = !rd_do && !wr_do && !axi.AWVALID;
assign axi.RID     = rd_arid                         ;

always_ff @(posedge axi.ACLK)
if (~axi.ARESETn) begin
   axi.RLAST   <= 1'b0 ;
   axi.RVALID  <= 1'b0 ;
   axi.RRESP   <= 2'h0 ;
end else begin
   axi.RLAST   <= rd_do && ack  ;
   axi.RVALID  <= rd_do && ack  ;
   axi.RRESP   <= {(rd_error || ack_cnt[5]),1'b0} ;  // 2'b10 SLVERR    2'b00 OK
   axi.RDATA   <= bus.rdata;
end

////////////////////////////////////////////////////////////////////////////////
// acknowledge protection
////////////////////////////////////////////////////////////////////////////////

always_ff @(posedge axi.ACLK)
if (~axi.ARESETn) begin
   ack_cnt   <= 6'h0 ;
end else begin
   if ((axi.ARVALID && axi.ARREADY) || (axi.AWVALID && axi.AWREADY))  // rd || wr request
      ack_cnt <= 6'h1;
   else if (ack)
      ack_cnt <= 6'h0;
   else if (|ack_cnt)
      ack_cnt <= ack_cnt + 6'h1;
end

assign ack = bus.ack || ack_cnt[5] || (rd_do && rd_errorw) || (wr_do && wr_errorw); // bus acknowledge or timeout or error

////////////////////////////////////////////////////////////////////////////////
// simple slave interface
////////////////////////////////////////////////////////////////////////////////

always_ff @(posedge axi.ACLK)
if (~axi.ARESETn) begin
   bus.wen <= 1'b0 ;
   bus.ren <= 1'b0 ;
//   bus.sel  <= {SW{1'b0}} ;
end else begin
   bus.wen <= wr_do && axi.WVALID && !wr_errorw;
   bus.ren <= axi.ARVALID && axi.ARREADY && !rd_errorw;
//   bus.sel  <= {SW{1'b1}} ;
end

assign bus.addr  = rd_do ? rd_araddr : wr_awaddr;
assign bus.wdata = wr_wdata                     ;

endmodule: axi4_slave
