HorvatMa/RedPitaya_scan/vivado/sources_1/imports/classic/rtl/classic/red_pitaya_daisy_tx.v

/**
 * $Id: red_pitaya_daisy_tx.v 961 2014-01-21 11:40:39Z matej.oblak $
 *
 * @brief Red Pitaya daisy chain communication module. TX serializator.
 *
 * @Author Matej Oblak
 *
 * (c) Red Pitaya  http://www.redpitaya.com
 *
 * This part of code is written in Verilog hardware description language (HDL).
 * Please visit http://en.wikipedia.org/wiki/Verilog
 * for more details on the language used herein.
 */



/**
 * GENERAL DESCRIPTION:
 *
 * This module takes care of transmitting serial data.
 *
 *
 *                      /------\
 *   TX PARALLEL -----> | PAR  | ---> TX DAT
 *                      |  ->  |
 *   TX REF CLK ------> | SER  | ---> TX CLK
 *                      \------/
 *                         ^
 *                         |
 *   CFG -------------------
 *
 *
 * Reference high-speed clock is used to generate TX link clock and to serialize
 * input data. Because serializer takes just 4-bits we need first to brake 
 * parallel data into 4 smaller parts, which are then used with OSERDESE2.
 *
 *
 * 
 */





module red_pitaya_daisy_tx
(
   // serial ports
   input                 ser_clk_i       ,  //!< reference high-speed clock
   output                ser_clk_o       ,  //!< TX high-speed clock
   output                ser_dat_o       ,  //!< TX high-speed clock

   // paralel ports
   input                 par_clk_i       ,  //!< parallel clock
   input                 par_rstn_i      ,  //!< parallel reset - active low

   output                par_rdy_o       ,  //!< parallel data can be transmitted
   input                 par_dv_i        ,  //!< parallel data valid
   input      [ 16-1: 0] par_dat_i          //!< parallel data
);





//---------------------------------------------------------------------------------
//
//  Serializer - clock (simple DDR FF)

ODDR #(
  .DDR_CLK_EDGE    ( "SAME_EDGE" ), // "OPPOSITE_EDGE" or "SAME_EDGE"
  .INIT            (  1'b1       ), // Initial value of Q: 1'b0 or 1'b1
  .SRTYPE          ( "ASYNC"     )  // Set/Reset type: "SYNC" or "ASYNC"
) ODDR_clk (
  .Q    (  ser_clk_o    ), // 1-bit DDR output
  .C    (  ser_clk_i    ), // 1-bit clock input
  .CE   (  1'b1         ), // 1-bit clock enable input
  .D1   (  1'b1         ), // 1-bit data input (positive edge)
  .D2   (  1'b0         ), // 1-bit data input (negative edge)
  .R    ( !par_rstn_i   ), // 1-bit reset
  .S    (  1'b0         )  // 1-bit set
);





//---------------------------------------------------------------------------------
//
//  Serializer - data

reg  [ 4-1: 0] par_dat ;

OSERDESE2
#(
  .DATA_RATE_OQ   ( "DDR"    ),
  .DATA_RATE_TQ   ( "SDR"    ),
  .DATA_WIDTH     (  4       ),
  .TRISTATE_WIDTH (  1       ),
  .SERDES_MODE    ( "MASTER" )
)
i_oserdese
(
  .D1             (  par_dat[0]     ),
  .D2             (  par_dat[1]     ),
  .D3             (  par_dat[2]     ),
  .D4             (  par_dat[3]     ),
  .D5             (  1'b0           ),
  .D6             (  1'b0           ),
  .D7             (  1'b0           ),
  .D8             (  1'b0           ),
  .T1             (  1'b0           ),
  .T2             (  1'b0           ),
  .T3             (  1'b0           ),
  .T4             (  1'b0           ),
  .SHIFTIN1       (),
  .SHIFTIN2       (),
  .SHIFTOUT1      (),
  .SHIFTOUT2      (),
  .OCE            (  1'b1           ),
  .CLK            (  ser_clk_i      ),
  .CLKDIV         (  par_clk_i      ),
  .OQ             (  ser_dat_o      ),
  .TQ             (),
  .OFB            (),
  .TFB            (),
  .TBYTEIN        (  1'b0           ),
  .TBYTEOUT       (),
  .TCE            (  1'b0           ),
  .RST            ( !par_rstn_i     )
);

    


//---------------------------------------------------------------------------------
//
//  Data control

reg  [ 2-1: 0] par_sel       ;
reg  [ 3-1: 0] par_dv        ;
reg  [12-1: 0] par_dat_r     ;


assign par_rdy_o = (par_sel==2'h0) ;

// First level of serializing. Break input 16-bits into nibbles.
// If value is not valid sent 0.
always @(posedge par_clk_i) begin
   case(par_sel)
    2'b00 : begin
               if (par_dv_i)
                  par_dat <= par_dat_i[3:0] ;
               else
                  par_dat <= 8'h0 ;
            end
    2'b01 : begin
               if (par_dv[0])
                  par_dat <= par_dat_r[3:0] ;
               else
                  par_dat <= 8'h0 ;
            end
    2'b10 : begin
               if (par_dv[1])
                  par_dat <= par_dat_r[7:4] ;
               else
                  par_dat <= 8'h0 ;
            end
    2'b11 : begin
               if (par_dv[2])
                  par_dat <= par_dat_r[11:8] ;
               else
                  par_dat <= 8'h0 ;
            end
   endcase
end


// latch input parallel data
always @(posedge par_clk_i) begin
   if (par_rstn_i == 1'b0) begin
      par_sel   <=  2'h0 ;
      par_dv    <=  3'b0 ;
      par_dat_r <= 12'h0 ;
   end
   else begin
      par_sel <= par_sel + 2'h1 ;

      par_dv  <= {par_dv[1:0], par_dv_i && par_rdy_o} ;

      if (par_dv_i && par_rdy_o)
         par_dat_r <= par_dat_i[15:4] ;

   end
end




endmodule
