HorvatMa/RedPitaya_scan/server/src/app/device_interface.h

#ifndef DEVICE_INTERFACE_h
#define DEVICE_INTERFACE_h

#include "oscilloscope.h"
#include "generator.h"
#include "common.h"

#define MAX 24000 
#define LEN_BYTES 4

// typedef struct Worker_args Worker_args; // Forward declaration

typedef struct {
    Acq *acq;
    Gen *gen;
} Device_interface;

int create_devices(Device_interface*);
void stop(Device_interface*);
void get_msg(int, char *);
int execute_command(Device_interface*, int, char**, char*, int, Worker_args*);
void read_n_bytes(int, char*, int);
void send_buffer(Device_interface*, char*, int);

#endif
