HorvatMa/RedPitaya_scan/(commit log)

2026-10-27 Initial commit: RedPitaya galvo scanner (FPGA, server2, viewer, docs)
    Fresh repository; history of the previous martinhorvat/RedPitaya_SiPM repo is not carried over.
    Contents: FPGA projects (deployed design in vivado/myproj), device-tree overlay, old C server,
    new server2 (image reconstruction on the Red Pitaya, TCP protocol v1, fake hardware backend),
    PyQt5 viewer with mock server, PCB, documentation (FPGA manual, protocol, design, TODO).
    Regenerable Vivado build outputs are excluded via .gitignore.
    Claude-Session: https://claude.ai/code/session_01FLjDB44yQBzjwFyCnuTNSQ
    [SHG_amp-B_Cu.gbl, SHG_amp-B_Mask.gbs, SHG_amp-B_Paste.gbp, SHG_amp-B_Silkscreen.gbo, SHG_amp-Edge_Cuts.gm1, SHG_amp-F_Cu.gtl, SHG_amp-F_Mask.gts, SHG_amp-F_Paste.gtp]
2026-10-27 server2: network layer, pixel formats, faster reconstruction; viewer updates
    - server2: config/volts layer, app threads + ring buffer + frame pool (drops on slow link),
    TCP server (protocol v1, STATUS), fake FPGA backend with sensor quantisation
    - reconstruction inner loop ~2x faster on the Cortex-A9 (4.1-4.3 Mrec/s on the board)
    - img.dtype float32/uint16/uint8 with per-frame scaling (72-byte frame header)
    - auto width capped at the number of fast-sensor levels
    - viewer: pixel format, received MB/s, frame bytes; tests for all formats
    - docs: protocol, design (sensor resolution limit), TODO (benchmarks, 100 Mbit link)
    Claude-Session: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
2026-10-27 server2: real FPGA backend (hw_uio.c) and hardware loopback test
    - hw_uio.c: UIO discovery/mmap, safe register writes (CTRL always 3, waveform 2 <= 12288,
    32-bit waveform stores), bitstream signature check, IRQ loop with lost-edge recovery
    - Makefile builds rpsipm_server (uio) next to rpsipm_server_fake
    - tests/hw_loopback.py: OUT1->IN1, generator/OUT2->IN2; fits pixel vs OUT1 voltage
    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
2026-10-29 FPGA: move DMA buffer to reserved 0x0A000000, fix timing, signed IN1
    - axi_s2mm: DMA base is now parameter BUFFER_BASE = 0x0A000000, inside the
    stock boot DT's reserved labuf region (was 0x19000000 = ordinary Linux RAM;
    the first server2 hardware run hung the kernel). fpga.dtso updated to match.
    - generate_top: register start_gen locally and register dac_val_1/2. Splits
    the failing start_gen -> FIFO/DAC paths (WNS -4.45 ns); +1 cycle latency.
    - integrator_top: integrate IN1 as a signed sample with 0 V = 0
    ({r[13], ~r[12:0]}, the official RP conversion) instead of 16383 - r.
    - server2: record_t.v is int32_t.
    - scripts/build_fpga.tcl: batch build for Vivado 2020.2 (bitstream + reports)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
    [axi_s2mm.sv, common.h, generate_top.v, integrator_top.v]
2026-10-29 FPGA: rebuilt bitstream for DMA buffer at 0x0A000000 (timing met)
    Vivado 2020.2 build of fpga-dma-buffer-fix: WNS +0.352 ns, WHS +0.067 ns,
    0 failing endpoints. Adds timing summary and utilization reports.
2026-10-29 server2: hw_uio: re-arm IRQ before clearing, hold the clear for ~4096-record chunks
    The FPGA sizes the next chunk to the FIFO backlog at clear time, so clearing at once
    settled at ~50-record chunks (~37k interrupts/s); reconstruction fell ~7 % behind at
    2.5 Mrec/s after 10-30 s. Holding the clear until ~4096 records have queued gives
    ~530 interrupts/s and no losses (70 s soak, 0 records lost). Re-enabling the UIO
    interrupt before the clear avoids a missed edge (seen as a 1-2 s stall).
    Claude-Session: https://claude.ai/code/session_01FLjDB7LDGnG4DsHYuR6R4R
2026-10-29 docs: SERVER_DESIGN §12 resolution vs samples rewritten
2026-10-29 server2 + viewer: fast-axis auto-calibration, external fast drive, display options
    - cal.fast_auto (default on): at start, fit a*sin + b*cos + c to IN2 at the fast
    frequency and map the measured sweep onto the commanded range; status reports
    the fit (fast_cal, in2_amp_v, ...). Width cap from the measured sensor steps.
    - fast.source external: a generator drives the fast galvo, OUT2 = 0 V; the
    frequency is measured from IN2 crossings, auto size follows it. Fake backend can
    simulate the generator (RPSIPM_FAKE_EXT).
    - Viewer: interpolate empty pixels (display only), true pixel aspect from volts,
    suggested fast frequency for a square auto image, auto-cal log, fast-drive field,
    externa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
2026-10-29 CLAUDE.md: bitstream deployed, loopback passed, interrupt fix, fast auto-cal/external drive
    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
